LuckfoxTECH/Luckfox-Omni3576-docs/README.md

# Luckfox Omni3576 Documentation

This repository contains the documentation, hardware resources, tools, and example code for Luckfox Omni3576

## Directory Structure

```text
Luckfox-Omni3576-docs/
├── Code/
├── Docs/
│   ├── datasheets/
│   ├── en/
│   └── zh/
├── Hardware/
│   ├── 3D Models/
│   ├── CAD/
│   └── Schematic/
├── Tools/
├── README.md
└── .gitignore
```

## Directory Description

| Directory | Description |
| --- | --- |
| `Code/` | Example code, demo projects, scripts, and source files related to Luckfox Omni3576 development. |
| `Docs/datasheets/` | Chip datasheets, module specifications, interface documents, and other reference PDFs. |
| `Docs/en/` | English user manuals, tutorials, quick-start guides, and development notes. |
| `Docs/zh/` | Chinese user manuals, tutorials, quick-start guides, and development notes. |
| `Hardware/3D Models/` | 3D model files for mechanical design, enclosure design, and product preview. |
| `Hardware/CAD/` | CAD design files,and hardware design source files. |
| `Hardware/Schematic/` | Circuit schematic files and related hardware reference documents. |
| `Tools/` | Utility software, flashing tools, and auxiliary development tools. |

## Notes

- Keep file names clear and descriptive.
- Place documents in the matching language folder when possible.
- Put large binary files only in the appropriate resource directory.
