LuckfoxTECH/Luckfox-Omni3576-docs/Hardware/Core3576-Pinout.xlsx

Sheet: 40P
 | SAI | CAN | I2C | SPI | UART | PWM | 次要功能 | 主要功能 | GPIO |  |  | GPIO | 主要功能 | 次要功能 | I2C | SPI | UART | PWM | SAI | CAN
 | 3.3V |  |  |  |  |  |  |  |  | 3.3V | 5V
18 |  |  | I2C0_SDA_M1 | - | UART8_RX_M2 | - |  | I2C0_SDA_M1 | GPIO0_C2_d | SDA0_1 | 5V
17 |  |  | I2C0_SCL_M1 | - | UART8_TX_M2 | - |  | I2C0_SCL_M1 | GPIO0_C1_d | SCL0_1 | GND
70 |  |  |  |  |  | - | UART8_TX_M1 |  | GPIO2_A6_d | TXD8_1 | TXD2_1 | GPIO4_B5_d | UART2_TX_M1 |  | I2C3_SCL_M0 | - | UART2_TX_M1 | - |  |  | 141
 | GND |  |  |  |  |  |  |  |  | GND | RXD2_1 | GPIO4_B4_d | UART2_RX_M1 |  | I2C3_SDA_M0 | - | UART2_RX_M1 | - |  |  | 140
98 | SAI3_SDO_M2 | CAN1_TX_M3 | - | - | UART3_CTSN_M0 | - |  |  | GPIO3_A2_d | GPIO17 | PWM2_0 | GPIO0_D3_d | PWM2_CH0 |  |  | - |  | PWM2_CH0 |  |  | 27
99 | SAI3_SDI_M2 | CAN1_RX_M3 | - | - | UART3_RTSN_M0 | - |  |  | GPIO3_A3_d | GPIO27 | GND
13 |  |  | I2C1_SDA_M1 | - |  | PWM1_CH1 | I2C1_SDA_M1 |  | GPIO0_B5_d | GPIO22 | GPIO23 | GPIO0_B4_d |  | I2C1_SCL_M1 | I2C1_SCL_M1 | - |  | PWM1_CH0 |  |  | 12
 | 3.3V |  |  |  |  |  |  |  |  | 3.3V | GPIO24 | GPIO0_C5_d |  |  | - | - |  | - |  |  | 21
24 |  |  | - | SPI0_MOSI_M0 | - | - |  | SPI0_MOSI_M0 | GPIO0_D0_d | MOSI0_0 | GND
25 |  |  | - | SPI0_MISO_M0 | - | - |  | SPI0_MISO_M0 | GPIO0_D1_d | MISO0_0 | GPIO25 | GPIO2_B5_d |  |  | - |  |  | - |  |  | 77
23 |  |  | I2C3_SDA_M1 | SPI0_CLK_M0 | - | - |  | SPI0_CLK_M0 | GPIO0_C7_d | SCLK0_0 | CE0_0 | GPIO0_C6_d | SPI0_CSN0_M0 |  | I2C3_SCL_M1 | SPI0_CSN0_M0 | - | - |  |  | 22
 | GND |  |  |  |  |  |  |  |  | GND | CE1_0 | GPIO0_C3_d | SPI0_CSN1_M0 |  | - | SPI0_CSN1_M0 | - | PWM0_CH1 |  |  | 19
79 |  |  | I2C8_SDA_M2 | - | UART7_RX_M0 | - |  | I2C8_SDA_M2 | GPIO2_B7_d | SDA8_2 | SCL8_2 | GPIO2_B6_d | I2C8_SCL_M2 |  | I2C8_SCL_M2 | - | UART7_TX_M0 | - |  |  | 78
71 |  |  |  | - | UART8_RX_M1 | - | UART8_RX_M1 |  | GPIO2_A7_d | RXD8_1 | GND
151 |  |  |  |  |  |  |  |  | GPIO4_C7_d | GPIO6 | GPIO12 | GPIO3_A0_d | UART3_TX_M0 |  | I2C7_SCL_M1 |  | UART3_TX_M0 | - | SAI3_SCLK_M2 |  | 96
97 | SAI3_LRCK_M2 |  | I2C7_SDA_M1 |  | UART3_RX_M0 |  | UART3_RX_M0 |  | GPIO3_A1_d | GPIO13 | GND
138 |  |  | - | SPI4_MISO_M2 | - | - | SPI4_MISO_M2 |  | GPIO4_B2_d | MISO4_2 | GPIO16 | GPIO2_D7_d |  |  | - |  |  |  |  |  | 95
72 |  |  | - | - |  | - |  |  | GPIO2_B0_d | GPIO26 | MOSI4_2 | GPIO4_B1_d |  | SPI4_MOSI_M2 |  | SPI4_MOSI_M2 | UART5_RX_M1 |  |  |  | 137
 | GND |  |  |  |  |  |  |  |  | GND | SCLK4_2 | GPIO4_B0_d |  | SPI4_CLK_M2 |  | SPI4_CLK_M2 | UART5_TX_M1 |  |  |  | 136

Sheet: 260P
Pin Number | Pin Name | IO Power domain | Omni3576 Definition |  | Pin Number | Pin Name | IO Power domain | Omni3576 Definition | @onepiece(onepiece)
1 | GND |  | GND |  | 2 | GND |  | GND
3 | USB2_OTG0_DP | - | USB2_OTG0_DP |  | 4 | USB2_OTG0_ID | - | NC
5 | USB2_OTG0_DM | - | USB2_OTG0_DM |  | 6 | USB2_OTG0_VBUSDET | - | USB2_OTG0_VBUSDET
7 | USB3_OTG0_SSRX1P / DP_TX_D0P | - | USB3_OTG0_SSRX1P |  | 8 | USB2_OTG1_DP | - | USB2_HOST1_DP
9 | USB3_OTG0_SSRX1N / DP_TX_D0N | - | USB3_OTG0_SSRX1N |  | 10 | USB2_OTG1_DM | - | USB2_HOST1_DM
11 | USB3_OTG0_SSTX1P / DP_TX_D1P | - | USB3_OTG0_SSTX1P |  | 12 | GND |  | GND
13 | USB3_OTG0_SSTX1N / DP_TX_D1N | - | USB3_OTG0_SSTX1N |  | 14 | NPOR |  | RESET_L
15 | USB3_OTG0_SSRX2P / DP_TX_D2P | - | USB3_OTG0_SSRX2N |  | 16 | REF_CLK0_OUT / AUPLL_CLK_IN_M0 / GPIO0_A0_d | 1V8 | REF_CLK0_OUT
17 | USB3_OTG0_SSRX2N / DP_TX_D2N | - | USB3_OTG0_SSRX2P |  | 18 | SDMMC0_DETN / SPI2_CSN1_M0 / GPIO0_A7_u | 1V8 | SDMMC0_DET_L
19 | USB3_OTG0_SSTX2P / DP_TX_D3P | - | USB3_OTG0_SSTX2P |  | 20 | AUPLL_CLK_IN_M1 / SPI2_CSN0_M0 / I2C0_SCL_M0 / GPIO0_B0_z | 1V8 | WIFI_WAKE_HOST_H
21 | USB3_OTG0_SSTX2N / DP_TX_D3N | - | USB3_OTG0_SSTX2N |  | 22 | SPI2_MISO_M0 / I2C0_SDA_M0 / GPIO0_B1_z | 1V8 | BT_WAKE_HOST_H
23 | GND |  | GND |  | 24 | REF_CLK1_OUT / I2C1_SCL_M1 / UART4_TX_M2 / PWM1_CH0_M0 / GPIO0_B4_d | 3V3 | GPIO_16
25 | MIPI_DPHY_DSI_TX_D0N / MIPI_CPHY_DSI_TX_TRIO0_A | - | MIPI_DPHY_DSI_TX_D0N |  | 26 | REF_CLK2_OUT / I2C1_SDA_M1 / UART4_RX_M2 / PWM1_CH1_M0 / GPIO0_B5_d | 3V3 | GPIO_15
27 | MIPI_DPHY_DSI_TX_D0P / MIPI_CPHY_DSI_TX_TRIO0_B | - | MIPI_DPHY_DSI_TX_D0P |  | 28 | SDMMC0_PWREN / SDMMC1_DETN_M2 / HDMI_TX_HPDIN_M1 / EDP_TX_HPDIN_M1 / PWM1_CH2_M0 / GPIO0_B6_d | 3V3 | SDMMC0_PWREN_H
29 | MIPI_DPHY_DSI_TX_D1N / MIPI_CPHY_DSI_TX_TRIO0_C | - | MIPI_DPHY_DSI_TX_D1N |  | 30 | I2C2_SCL_M0 / UART1_TX_M0 / NPU_AVS / PWM1_CH4_M0 / GPIO0_B7_d | 3V3 | I2C2_SCL_M0_CC_RTC
31 | MIPI_DPHY_DSI_TX_D1P / MIPI_CPHY_DSI_TX_TRIO1_A | - | MIPI_DPHY_DSI_TX_D1P |  | 32 | I2C2_SDA_M0 / UART1_RX_M0 / CPULIT_AVS / PWM1_CH3_M0 / GPIO0_C0_d | 3V3 | I2C2_SDA_M0_CC_RTC
33 | MIPI_DPHY_DSI_TX_CLKN / MIPI_CPHY_DSI_TX_TRIO1_B | - | MIPI_DPHY_DSI_TX_CLKN |  | 34 | I2C0_SCL_M1 / UART8_TX_M2 / I3C0_SCL_M0 / GPIO0_C1_d | 3V3 | GPIO_5
35 | MIPI_DPHY_DSI_TX_CLKP / MIPI_CPHY_DSI_TX_TRIO1_C | - | MIPI_DPHY_DSI_TX_CLKP |  | 36 | I2C0_SDA_M1 / UART8_RX_M2 / I3C0_SDA_M0 / GPIO0_C2_d | 3V3 | GPIO_3
37 | MIPI_DPHY_DSI_TX_D2N / MIPI_CPHY_DSI_TX_TRIO2_A | - | MIPI_DPHY_DSI_TX_D2N |  | 38 | PDM0_CLK1_M0 / HDMI_TX_CEC_M1 / SPI0_CSN1_M0 / PWM0_CH1_M0 / GPIO0_C3_d | 3V3 | GPIO_26
39 | MIPI_DPHY_DSI_TX_D2P / MIPI_CPHY_DSI_TX_TRIO2_B | - | MIPI_DPHY_DSI_TX_D2P |  | 40 | SAI0_MCLK_M1 / PDM0_CLK0_M0 / UART10_TX_M2 / PWM0_CH0_M0 / GPIO0_C4_d | 3V3 | PWM0_CH0_M0_IR
41 | MIPI_DPHY_DSI_TX_D3N / MIPI_CPHY_DSI_TX_TRIO2_C | - | MIPI_DPHY_DSI_TX_D3N |  | 42 | SAI0_SDO0_M1 / DP_HPDIN_M1 / UART10_RX_M2 / I3C0_SDA_PU_M0 / GPIO0_C5_d | 3V3 | GPIO_18
43 | MIPI_DPHY_DSI_TX_D3P / NO_USE | - | MIPI_DPHY_DSI_TX_D3P |  | 44 | SAI0_SCLK_M1 / I2C3_SCL_M1 / SPI0_CSN0_M0 / GPIO0_C6_d | 3V3 | GPIO_24
45 | GND |  | GND |  | 46 | SAI0_LRCK_M1 / I2C3_SDA_M1 / SPI0_CLK_M0 / GPIO0_C7_d | 3V3 | GPIO_23
47 | MIPI_DPHY_CSI0_RX_D0N / MIPI_CPHY_CSI_RX_TRIO0_A | - | MIPI_DPHY_CSI0_RX_D0N |  | 48 | SAI0_SDI0_M1 / PDM0_SDI0_M0 / SPI0_MOSI_M0 / GPIO0_D0_d | 3V3 | GPIO_19
49 | MIPI_DPHY_CSI0_RX_D0P / MIPI_CPHY_CSI_RX_TRIO0_B | - | MIPI_DPHY_CSI0_RX_D0P |  | 50 | SAI0_SDI1_M1 / SAI0_SDO3_M1 / PDM0_SDI1_M0 / SPI0_MISO_M0 / GPIO0_D1_d | 3V3 | GPIO_21
51 | MIPI_DPHY_CSI0_RX_D1N / MIPI_CPHY_CSI_RX_TRIO0_C | - | MIPI_DPHY_CSI0_RX_D1N |  | 52 | SAI0_SDI2_M1 / SAI0_SDO2_M1 / PDM0_SDI2_M0 / I2C4_SCL_M0 / CPUBIG_AVS / PWM1_CH5_M0 / UART1_CTSN_M0 / GPIO0_D2_d | 3V3 | PCIE0_WAKEn_M0
53 | MIPI_DPHY_CSI0_RX_D1P / MIPI_CPHY_CSI_RX_TRIO1_A | - | MIPI_DPHY_CSI0_RX_D1P |  | 54 | SAI0_SDI3_M1 / SAI0_SDO1_M1 / PDM0_SDI3_M0 / I2C4_SDA_M0 / GPU_AVS / PWM2_CH0_M0 / UART1_RTSN_M0 / GPIO0_D3_d | 3V3 | GPIO_12
55 | MIPI_DPHY_CSI0_RX_CLKN / MIPI_CPHY_CSI_RX_TRIO1_B | - | MIPI_DPHY_CSI0_RX_CLKN |  | 56 | UART0_TX_M0 / JTAG_TCK_M1 / GPIO0_D4_u | 3V3 | UART0_TX_M0_DEBUG
57 | MIPI_DPHY_CSI0_RX_CLKP / MIPI_CPHY_CSI_RX_TRIO1_C | - | MIPI_DPHY_CSI0_RX_CLKP |  | 58 | UART0_RX_M0 / JTAG_TMS_M1 / GPIO0_D5_u | 3V3 | UART0_RX_M0_DEBUG
59 | MIPI_DPHY_CSI0_RX_D2N / MIPI_CPHY_CSI_RX_TRIO2_A | - | MIPI_DPHY_CSI0_RX_D2N |  | 60 | GND |  | GND
61 | MIPI_DPHY_CSI0_RX_D2P / MIPI_CPHY_CSI_RX_TRIO2_B | - | MIPI_DPHY_CSI0_RX_D2P |  | 62 | HDMI_TX_SBDN / EDP_TX_AUXN | - | HDMI_TX_SBDN
63 | MIPI_DPHY_CSI0_RX_D3N / MIPI_CPHY_CSI_RX_TRIO2_C | - | MIPI_DPHY_CSI0_RX_D3N |  | 64 | HDMI_TX_SBDP / EDP_TX_AUXP | - | HDMI_TX_SBDP
65 | MIPI_DPHY_CSI0_RX_D3P / NO_USE | - | MIPI_DPHY_CSI0_RX_D3P |  | 66 | DSM_AUD_LP_M1 / SAI4_MCLK_M2 / HDMI_TX_CEC_M0 / I2C7_SCL_M3 / SPI4_CSN1_M0 / UART11_TX_M2 / PWM1_CH5_M1 / GPIO4_C0_d | 3V3 | HDMI_TX_CEC_PORT
67 | GND |  | GND |  | 68 | DSM_AUD_LN_M1 / HDMI_TX_HPDIN_M0 / PCIE1_CLKREQN_M3 / I2C7_SDA_M3 / EDP_TX_HPDIN_M0 / UART11_RX_M2 / PWM0_CH1_M1 / GPIO4_C1_d | 3V3 | HDMITX_HPDIN / HDMITX_SBDN
69 | HDMI_TX_D3N / EDP_TX_D3N | - | HDMI_TX_D3N |  | 70 | DSM_AUD_RP_M1 / HDMI_TX_SCL / I2C2_SCL_M3 / CAN0_TX_M1 / UART9_TX_M2 / PWM2_CH0_M1 / GPIO4_C2_d | 3V3 | HDMI_TX_SCL_PORT
71 | HDMI_TX_D3P / EDP_TX_D3P | - | HDMI_TX_D3P |  | 72 | DSM_AUD_RN_M1 / HDMI_TX_SDA / I2C2_SDA_M3 / CAN0_RX_M1 / UART9_RX_M2 / PWM2_CH1_M1 / GPIO4_C3_d | 3V3 | HDMI_TX_SDA_PORT
73 | HDMI_TX_D0N / EDP_TX_D0N | - | HDMI_TX_D0N |  | 74 | ISP_PRELIGHT_TRIG_M1 / SAI4_LRCK_M2 / DP_HPDIN_M0 / I2C3_SCL_M3 / SPI4_CSN0_M0 / UART6_TX_M3 / PWM2_CH6_M1 / GPIO4_C4_d | 3V3 | TYPEC_DPTX_AUX_PUPDCTL1
75 | HDMI_TX_D0P / EDP_TX_D0P | - | HDMI_TX_D0P |  | 76 | ISP_FLASH_TRIGOUT_M1 / SAI4_SDO_M2 / VP0_SYNC_OUT / SATA1_ACTLED_M1 / I2C3_SDA_M3 / SPI4_MOSI_M0 / UART6_RX_M3 / PWM2_CH5_M1 / GPIO4_C5_d | 3V3 | TYPEC_DPTX_AUX_PUPDCTL2
77 | HDMI_TX_D1N / EDP_TX_D1N | - | HDMI_TX_D1N |  | 78 | SAI4_SDI_M2 / VP1_SYNC_OUT / PCIE0_CLKREQN_M3 / SATA0_ACTLED_M1 / I2C6_SCL_M3 / SPI4_MISO_M0 / CAN1_TX_M1 / PWM2_CH2_M1 / GPIO4_C6_d | 3V3 | HDMI_TX_ON_H
79 | HDMI_TX_D1P / EDP_TX_D1P | - | HDMI_TX_D1P |  | 80 | SAI4_SCLK_M2 / VP2_SYNC_OUT / I2C6_SDA_M3 / SPI4_CLK_M0 / CAN1_RX_M1 / PWM2_CH3_M1 / GPIO4_C7_d | 3V3 | GPIO_31
81 | HDMI_TX_D2N / EDP_TX_D2N | - | HDMI_TX_D2N |  | 82 | DP_TX_AUXP | - | DP_TX_AUXP
83 | HDMI_TX_D2P / EDP_TX_D2P | - | HDMI_TX_D2P |  | 84 | DP_TX_AUXN | - | DP_TX_AUXN
85 | GND |  | GND |  | 86 | MIPI_DPHY_CSI1_RX_CLKN | - | MIPI_DPHY_CSI1_RX_CLKN
87 | MIPI_DPHY_CSI1_RX_D3N / MIPI_DPHY_CSI2_RX_D1N | - | MIPI_DPHY_CSI1_RX_D3N |  | 88 | MIPI_DPHY_CSI1_RX_CLKP | - | MIPI_DPHY_CSI1_RX_CLKP
89 | MIPI_DPHY_CSI1_RX_D3P / MIPI_DPHY_CSI2_RX_D1P | - | MIPI_DPHY_CSI1_RX_D3P |  | 90 | MIPI_DPHY_CSI2_RX_CLKN | - | NC
91 | MIPI_DPHY_CSI1_RX_D2N / MIPI_DPHY_CSI2_RX_D0N | - | MIPI_DPHY_CSI1_RX_D2N |  | 92 | MIPI_DPHY_CSI2_RX_CLKP | - | NC
93 | MIPI_DPHY_CSI1_RX_D2P / MIPI_DPHY_CSI2_RX_D0P | - | MIPI_DPHY_CSI1_RX_D2P |  | 94 | MIPI_DPHY_CSI4_RX_CLKN | - | NC
95 | MIPI_DPHY_CSI1_RX_D1N | - | MIPI_DPHY_CSI1_RX_D1N |  | 96 | MIPI_DPHY_CSI4_RX_CLKP | - | NC
97 | MIPI_DPHY_CSI1_RX_D1P | - | MIPI_DPHY_CSI1_RX_D1P |  | 98 | GND |  | GND
99 | MIPI_DPHY_CSI1_RX_D0N | - | MIPI_DPHY_CSI1_RX_D0N |  | 100 | PCIE0_REFCLKP | - | PCIE0_REFCLKP
101 | MIPI_DPHY_CSI1_RX_D0P | - | MIPI_DPHY_CSI1_RX_D0P |  | 102 | PCIE0_REFCLKN | - | PCIE0_REFCLKN
103 | GND |  | GND |  | 104 | PCIE1_REFCLKP | - | NC
105 | PCIE0_RXP / SATA0_RXP | - | PCIE0_RXP |  | 106 | PCIE1_REFCLKN | - | NC
107 | PCIE0_RXN / SATA0_RXN | - | PCIE0_RXN |  | 108 | MIPI_DPHY_CSI3_RX_CLKN | - | NC
109 | PCIE0_TXP / SATA0_TXP | - | PCIE0_TXN |  | 110 | MIPI_DPHY_CSI3_RX_CLKP | - | NC
111 | PCIE0_TXN / SATA0_TXN | - | PCIE0_TXP |  | 112 | GND |  | GND
113 | GND |  | GND |  | 114 | ETH1_RXD2_M1 / SDMMC1_D0_M0 / SAI3_SCLK_M1 / I2C9_SDA_M1 / SPI1_CLK_M0 / PCIE1_CLKREQN_M1 / PWM1_CH0_M1 / GPIO1_B4_d | 1V8 | SDMMC1_D0_M0
115 | PCIE1_TXP / SATA1_TXP / USB3_OTG1_SSTXP | - | USB3_HOST1_SSTXP |  | 116 | ETH1_RXD3_M1 / SDMMC1_D1_M0 / SAI3_LRCK_M1 / I2C9_SCL_M1 / SPI1_MOSI_M0 / PWM1_CH1_M1 / GPIO1_B5_d | 1V8 | SDMMC1_D1_M0
117 | PCIE1_TXN / SATA1_TXN / USB3_OTG1_SSTXN | - | USB3_HOST1_SSTXN |  | 118 | ETH1_RXCLK_M1 / SDMMC1_D2_M0 / SAI3_SDO_M1 / UART3_CTSN_M2 / SPI1_MISO_M0 / PCIE0_CLKREQN_M1 / GPIO1_B6_d | 1V8 | SDMMC1_D2_M0
119 | PCIE1_RXP / SATA1_RXP / USB3_OTG1_SSRXP | - | USB3_HOST1_SSRXP |  | 120 | ETH1_TXD2_M1 / SDMMC1_D3_M0 / SAI3_SDI_M1 / UART3_RTSN_M2 / SPI1_CSN0_M0 / GPIO1_B7_d | 1V8 | SDMMC1_D3_M0
121 | PCIE1_RXN / SATA1_RXN / USB3_OTG1_SSRXN | - | USB3_HOST1_SSRXN |  | 122 | ETH1_TXD3_M1 / SDMMC1_CMD_M0 / PDM0_SDI2_M2 / UART3_TX_M2 / SPI1_CSN1_M0 / PWM0_CH0_M1 / GPIO1_C0_d | 1V8 | SDMMC1_CMD_M0
123 | GND |  | GND |  | 124 | ETH1_TXCLK_M1 / SDMMC1_CLK_M0 / SAI3_MCLK_M1 / PDM0_CLK0_M2 / UART3_RX_M2 / GPIO1_C1_d | 1V8 | SDMMC1_CLK_M0
125 | MIPI_DPHY_CSI3_RX_D3N / MIPI_DPHY_CSI4_RX_D1N | - | NC |  | 126 | ETH1_PPSCLK_M1 / SDMMC1_PWREN_M0 / FSPI1_RSTN_M1 / FSPI1_CSN1_M1 / UART4_RTSN_M1 / I2C6_SCL_M1 / SPI2_CSN1_M1 / PWM1_CH2_M1 / GPIO1_C2_u | 1V8 | UART4_RTSN_M1
127 | MIPI_DPHY_CSI3_RX_D3P / MIPI_DPHY_CSI4_RX_D1P | - | NC |  | 128 | ETH1_PPSTRIG_M1 / SDMMC1_DETN_M0 / FSPI1_CSN0_M1 / UART4_CTSN_M1 / I2C6_SDA_M1 / SPI2_CSN0_M1 / GPIO1_C3_u | 1V8 | UART4_CTSN_M1
129 | MIPI_DPHY_CSI3_RX_D2N / MIPI_DPHY_CSI4_RX_D0N | - | NC |  | 130 | ETH1_TXD0_M1 / FSPI1_D0_M1 / UART4_TX_M1 / UART2_RTSN_M0 / SPI2_MOSI_M1 / PCIE0_BUTTONRSTN / GPIO1_C4_d | 1V8 | UART4_TX_M1
131 | MIPI_DPHY_CSI3_RX_D2P / MIPI_DPHY_CSI4_RX_D0P | - | NC |  | 132 | ETH1_TXD1_M1 / FSPI1_D1_M1 / UART4_RX_M1 / UART2_CTSN_M0 / SPI2_MISO_M1 / PCIE1_BUTTONRSTN / GPIO1_C5_d | 1V8 | UART4_RX_M1
133 | MIPI_DPHY_CSI3_RX_D1N | - | NC |  | 134 | ETH1_RXD0_M1 / FSPI1_D3_M1 / PDM0_SDI1_M2 / UART2_RX_M0 / I2C8_SDA_M1 / SATA_CPDET / GPIO1_C7_d | 1V8 | BT_REG_ON_H
135 | MIPI_DPHY_CSI3_RX_D1P | - | NC |  | 136 | ETH_CLK1_25M_OUT_M1 / FSPI1_CLK_M1 / PDM0_CLK1_M2 / SPDIF_TX1_M2 / UART10_CTSN_M1 / I2C5_SDA_M1 / SPI2_CLK_M1 / SATA_MPSWIT / CLK1_32K_OUT / GPIO1_D5_d | 1V8 | CLK1_32K_OUT_WIFI
137 | MIPI_DPHY_CSI3_RX_D0N | - | NC |  | 138 | ETH1_MCLK_M1 / SAI2_MCLK_M0 / PDM0_SDI3_M2 / SPDIF_RX1_M2 / UART10_RTSN_M1 / I2C5_SCL_M1 / GPIO1_D4_d | 1V8 | HOST_WAKE_BT_H
139 | MIPI_DPHY_CSI3_RX_D0P | - | NC |  | 140 | RTC_BAT | - | RTC_BAT
141 | GND |  | GND |  | 142 | CAM_CLK2_OUT_M1 / ETH1_MCLK_M0 / ETH_CLK0_25M_OUT_M1 / SAI0_SDO3_M0 / SPDIF_TX0_M2 / UART9_CTSN_M0 / SPI3_CSN1_M0 / PWM2_CH7_M2 / GPIO2_D7_d | 3V3 | GPIO_36
143 | ETH1_TXCTL_M1 / FSPI1_D2_M1 / PDM0_SDI0_M2 / UART2_TX_M0 / I2C8_SCL_M1 / SATA_CPPOD / GPIO1_C6_d | 1V8 | WIFI_REG_ON_H |  | 144 | VI_CIF_CLKO / ETH1_PPSCLK_M0 / ETH0_RXCTL_M1 / SAI3_SDO_M2 / SPDIF_RX1_M1 / UART3_CTSN_M0 / SPI3_MISO_M0 / CAN1_TX_M3 / MIPI_TE_M1 / GPIO3_A2_d | 3V3 | GPIO_11
- | - | - | -
145 | ETH1_RXCTL_M1 / SAI2_SCLK_M0 / UART10_RX_M1 / I3C0_SDA_PU_M1 / GPIO1_D1_d | 1V8 | SAI2_SCLK_M0 |  | 146 | SDMMC0_D0 / FSPI1_D0_M0 / DSM_AUD_LP_M0 / UART0_RX_M1 / UART7_RX_M2 / I2C8_SCL_M0 / SPI0_MOSI_M1 / CAN0_RX_M0 / PWM2_CH2_M0 / GPIO2_A0_d | 3V3 | SDMMC0_D0
147 | ETH1_MDIO_M1 / SAI2_SDI_M0 / I3C0_SDA_M1 / PWM1_CH4_M1 / GPIO1_D3_d | 1V8 | SAI2_SDI_M0 |  | 148 | SDMMC0_D1 / FSPI1_D1_M0 / DSM_AUD_LN_M0 / SAI3_MCLK_M3 / UART0_TX_M1 / UART7_TX_M2 / I2C8_SDA_M0 / SPI0_MISO_M1 / CAN0_TX_M0 / PWM2_CH3_M0 / GPIO2_A1_d | 3V3 | SDMMC0_D1
149 | ETH1_RXD1_M1 / SAI2_SDO_M0 / UART10_TX_M1 / GPIO1_D0_d | 1V8 | SAI2_SDO_M0 |  | 150 | SDMMC0_D2 / FSPI1_D2_M0 / DSM_AUD_RP_M0 / SAI3_LRCK_M3 / JTAG_TCK_M0 / UART5_RTSN_M2 / SPI0_CSN1_M1 / CAN1_RX_M0 / I3C1_SCL_M1 / GPIO2_A2_d | 3V3 | SDMMC0_D2
151 | ETH1_MDC_M1 / SAI2_LRCK_M0 / I3C0_SCL_M1 / PWM1_CH3_M1 / GPIO1_D2_d | 1V8 | SAI2_LRCK_M0 |  | 152 | SDMMC0_D3 / FSPI1_D3_M0 / DSM_AUD_RN_M0 / SAI3_SDI_M3 / JTAG_TMS_M0 / UART5_CTSN_M2 / CAN1_TX_M0 / I3C1_SDA_M1 / GPIO2_A3_d | 3V3 | SDMMC0_D3
153 | VI_CIF_D15 / SDMMC1_D0_M1 / ETH0_RXD0_M1 / SAI0_SDO0_M0 / UART8_TX_M1 / SPI4_CSN1_M3 / I2C4_SCL_M2 / GPIO2_A6_d | 3V3 | GPIO_7 |  | 154 | SDMMC0_CMD / FSPI1_CSN0_M0 / SAI3_SDO_M3 / UART5_RX_M2 / I2C5_SDA_M0 / SPI0_CSN0_M1 / PWM2_CH4_M0 / GPIO2_A4_d | 3V3 | SDMMC0_CMD
155 | VI_CIF_CLKI / ETH1_PTP_REFCLK_M0 / ETH0_RXD1_M1 / SAI3_SDI_M2 / SPDIF_TX1_M1 / UART3_RTSN_M0 / SPI3_CSN0_M0 / CAN1_RX_M3 / GPIO3_A3_d | 3V3 | GPIO_13 |  | 156 | SDMMC0_CLK / FSPI1_CLK_M0 / SAI3_SCLK_M3 / TEST_CLK_OUT / UART5_TX_M2 / I2C5_SCL_M0 / SPI0_CLK_M1 / I3C1_SDA_PU_M1 / GPIO2_A5_d | 3V3 | SDMMC0_CLK
157 | VI_CIF_D6 / ETH0_RXD2_M1 / SAI0_LRCK_M0 / UART7_RX_M0 / UART8_CTSN_M1 / I2C8_SDA_M2 / GPIO2_B7_d | 3V3 | GPIO_27 |  | 158 | VO_LCDC_D12 / VO_EBC_SDDO12 / ETH0_PPSTRIG_M0 / SAI1_SDI0_M1 / DSMC_DQS0 / FLEXBUS1_D10 / FLEXBUS1_CSN_M0 / UART2_RX_M2 / UART3_CTSN_M1 / I2C4_SDA_M3 / GPIO3_B7_d | 1V8 | I2C4_SDA_M3_MIPI_CAM0 / 2
159 | VI_CIF_D7 / ETH1_PTP_REFCLK_M1 / ETH0_RXD3_M1 / SAI0_SCLK_M0 / UART7_TX_M0 / UART8_RTSN_M1 / I2C8_SCL_M2 / GPIO2_B6_d | 3V3 | GPIO_28 | 3 | 160 | VO_LCDC_D11 / VO_EBC_SDDO11 / ETH0_PPSCLK_M0 / SAI1_SDO3_M1 / DSMC_DATA7 / FLEXBUS1_D9 / UART2_TX_M2 / UART3_RTSN_M1 / I2C4_SCL_M3 / GPIO3_C0_d | 1V8 | I2C4_SCL_M3_MIPI_CAM0 / 2
161 | VI_CIF_D8 / SDMMC1_DETN_M1 / ETH0_RXCLK_M1 / SAI0_MCLK_M0 / PDM0_CLK0_M3 / UART7_RTSN_M0 / SPI4_MISO_M3 / SATA1_ACTLED_M0 / GPIO2_B5_d | 3V3 | GPIO_22 |  | 162 | VO_LCDC_D10 / VO_EBC_SDDO10 / ETH0_PTP_REFCLK_M0 / SAI1_SDO2_M1 / DSMC_DATA6 / FLEXBUS1_D8 / UART11_RX_M0 / SPI2_MISO_M2 / I2C5_SDA_M3 / CAN0_RX_M3 / GPIO3_C1_d | 1V8 | I2C5_SDA_M3_MIPI_CAM1 / HDMI_RX
163 | VI_CIF_D14 / SDMMC1_D1_M1 / ETH0_TXCTL_M1 / SAI0_SDO1_M0 / UART8_RX_M1 / I2C4_SDA_M2 / GPIO2_A7_d | 3V3 | GPIO_29 |  | 164 | VO_LCDC_D7 / VO_EBC_SDDO7 / SAI1_SDO1_M1 / DSMC_DATA5 / FLEXBUS1_D7 / UART11_TX_M0 / SPI2_CSN0_M2 / I2C5_SCL_M3 / CAN0_TX_M3 / GPIO3_C4_d | 1V8 | I2C5_SCL_M3_MIPI_CAM1 / HDMI_RX
165 | VI_CIF_D12 / SDMMC1_D3_M1 / ETH0_TXD0_M1 / SAI0_SDI1_M0 / PDM0_SDI2_M3 / UART1_RX_M1 / GPIO2_B1_d | 3V3 | PCIE0_PERSTn |  | 166 | VO_LCDC_D6 / VO_EBC_SDDO6 / SAI1_SDO0_M1 / DSMC_DATA4 / FLEXBUS1_D6 / UART8_RX_M0 / SPI1_MISO_M2 / PWM2_CH2_M3 / GPIO3_C5_d | 1V8 | DSI_IO1
167 | VI_CIF_D13 / SDMMC1_D2_M1 / ETH0_TXD1_M1 / SAI0_SDI0_M0 / PDM0_SDI3_M3 / UART1_TX_M1 / GPIO2_B0_d | 3V3 | GPIO_37 |  | 168 | VO_LCDC_D5 / VO_EBC_SDDO5 / SAI1_LRCK_M1 / DSMC_DATA3 / FLEXBUS1_D5 / UART8_TX_M0 / SPI1_MOSI_M2 / GPIO3_C6_d | 1V8 | CSI0_IO0
169 | GND |  | GND |  | 170 | VO_LCDC_D4 / VO_EBC_SDDO4 / SAI1_SCLK_M1 / DSMC_DATA2 / FLEXBUS1_D4 / UART8_RTSN_M0 / SPI1_CLK_M2 / GPIO3_C7_d | 1V8 | CSI1_IO1
171 | VI_CIF_D3 / ETH1_RXCLK_M0 / ETH0_PPSTRIG_M1 / SAI2_SCLK_M1 / PDM1_SDI2_M0 / UART11_CTSN_M1 / SPI1_MOSI_M1 / PWM1_CH2_M2 / GPIO2_C2_d | 3V3 | GMAC1_RXCLK_M0 |  | 172 | VO_LCDC_D3 / VO_EBC_SDDO3 / SAI1_MCLK_M1 / DSMC_DATA1 / FLEXBUS1_D3 / UART8_CTSN_M0 / SPI1_CSN0_M2 / PWM2_CH3_M3 / GPIO3_D0_d | 1V8 | CSI1_IO0
173 | VI_CIF_D0 / ETH1_TXCLK_M0 / SAI2_SDI_M1 / PDM1_CLK0_M0 / UART11_RX_M1 / SPI1_CLK_M1 / PWM1_CH4_M2 / GPIO2_C5_d | 3V3 | GMAC1_TXCLK_M0 |  | 174 | VO_LCDC_DEN / VO_EBC_SDLE / SAI1_SDI1_M1 / DSMC_DATA0 / FLEXBUS1_D1 / UART5_RX_M0 / SPI3_CLK_M1 / I2C3_SCL_M2 / GPIO3_D4_d | 1V8 | USBC_INT
175 | VI_CIF_HREF / ETH0_MDIO_M1 / SAI3_SCLK_M2 / UART3_TX_M0 / SPI3_CLK_M0 / I2C7_SCL_M1 / GPIO3_A0_d | 3V3 | GPIO_32 |  | 176 | VO_LCDC_HSYNC / VO_EBC_GDCLK / SAI1_SDI2_M1 / DSMC_CLKP / FLEXBUS1_D0 / UART5_TX_M0 / SPI3_MISO_M1 / I2C3_SDA_M2 / GPIO3_D5_d | 1V8 | USBC_PWR
177 | VI_CIF_VSYNC / ETH1_PPSTRIG_M0 / ETH0_MDC_M1 / SAI3_LRCK_M2 / UART3_RX_M0 / SPI3_MOSI_M0 / I2C7_SDA_M1 / GPIO3_A1_d | 3V3 | GPIO_33 |  | 178 | VO_LCDC_VSYNC / VO_EBC_SDCLK / SAI1_SDI3_M1 / DSMC_CLKN / FLEXBUS1_CLK / UART5_CTSN_M0 / SPI3_MOSI_M1 / PWM2_CH6_M3 / GPIO3_D6_d | 1V8 | FAN_PWM
179 | CAM_CLK1_OUT_M1 / ETH_CLK1_25M_OUT_M0 / ETH0_MCLK_M1 / SAI3_MCLK_M2 / SPDIF_RX0_M2 / UART9_RTSN_M0 / I3C1_SDA_PU_M0 / PWM2_CH6_M2 / GPIO2_D6_d | 3V3 | ETH_CLK1_25M_OUT_M0 |  | 180 | SPDIF_RX0_M1 / CAM_CLK1_OUT_M0 / SAI4_LRCK_M1 / DSMC_INT0 / FLEXBUS0_D13_M0 / FLEXBUS1_D14_M0 / FLEXBUS1_CSN_M3 / UART3_TX_M1 / SPI1_CSN1_M2 / I2C7_SCL_M2 / MIPI_TE_M2 / GPIO4_A0_d | 1V8 | PCIE_PWR
181 | ISP_PRELIGHT_TRIG_M0 / ETH1_MDC_M0 / UART6_RTSN_M1 / I2C9_SDA_M2 / PWM2_CH4_M2 / GPIO2_D4_d | 3V3 | GMAC1_MDC_M0 |  | 182 | VO_POST_EMPTY / SPDIF_TX0_M1 / CAM_CLK2_OUT_M0 / SAI4_SDO_M1 / DSMC_INT2 / FLEXBUS0_D14_M0 / FLEXBUS1_D13_M0 / FLEXBUS0_CSN_M1 / UART3_RX_M1 / I2C7_SDA_M2 / GPIO4_A1_d | 1V8 | M.2M_ALERT
183 | ISP_FLASH_TRIGOUT_M0 / ETH1_MDIO_M0 / UART6_CTSN_M1 / I2C9_SCL_M2 / PWM2_CH5_M2 / GPIO2_D5_d | 3V3 | GMAC1_MDIO_M0 |  | 184 | VO_LCDC_CLK / VO_EBC_SDOE / CAM_CLK0_OUT_M0 / SAI4_SCLK_M1 / DSMC_RESETN / FLEXBUS0_D15_M0 / FLEXBUS1_D12_M0 / FLEXBUS1_CSN_M1 / UART5_RTSN_M0 / SPI3_CSN1_M1 / PWM2_CH7_M3 / GPIO3_D7_d | 1V8 | CSI0_IO1
185 | VI_CIF_D9 / SDMMC1_PWREN_M1 / ETH0_TXD2_M1 / SAI0_SDI3_M0 / PDM0_SDI0_M3 / UART7_CTSN_M0 / SPI4_MOSI_M3 / SATA0_ACTLED_M0 / GPIO2_B4_d | 3V3 | GMAC1_RSTn |  | 186 | GND |  | GND
187 | VI_CIF_D11 / SDMMC1_CMD_M1 / ETH0_TXD3_M1 / SAI0_SDI2_M0 / PDM0_SDI1_M3 / UART1_CTSN_M1 / SPI4_CSN0_M3 / PCIE0_CLKREQN_M0 / GPIO2_B2_d | 3V3 | PCIE0_CLKREQn_M0 |  | 188 | SAI1_MCLK_M0 / SAI4_MCLK_M0 / AUPLL_CLK_IN_M2 / PWM2_CH5_M0 / GPIO4_A2_d | 3V3 | SAI1_MCLK_M0
189 | ETH1_RXCTL_M0 / UART6_RX_M1 / I3C1_SDA_M0 / PWM2_CH3_M2 / GPIO2_D3_d | 3V3 | GMAC1_RXCTL_M0 |  | 190 | SAI1_LRCK_M0 / FLEXBUS1_D12_M1 / SPI4_CSN1_M2 / UART5_CTSN_M1 / I2C2_SDA_M2 / PCIE1_CLKREQN_M2 / GPIO4_A5_d | 3V3 | SAI1_LRCK_M0
191 | ETH1_RXD0_M0 / SAI4_SDO_M3 / UART4_RX_M0 / I2C6_SDA_M2 / PWM2_CH1_M2 / GPIO2_D1_d | 3V3 | GMAC1_RXD0_M0 |  | 192 | SAI1_SCLK_M0 / FLEXBUS1_CSN_M4 / SPI3_CSN0_M2 / UART5_RTSN_M1 / I2C2_SCL_M2 / PWM2_CH4_M1 / GPIO4_A3_d | 3V3 | SAI1_SCLK_M0
193 | CAM_CLK0_OUT_M1 / ETH1_RXD1_M0 / SAI4_MCLK_M3 / UART6_TX_M1 / I3C1_SCL_M0 / PWM2_CH2_M2 / GPIO2_D2_d | 3V3 | GMAC1_RXD1_M0 |  | 194 | SAI4_LRCK_M0 / PDM1_CLK0_M1 / FLEXBUS0_D14_M1 / SPI3_MISO_M2 / UART6_RX_M0 / I2C4_SDA_M1 / CAN0_RX_M2 / GPIO4_A6_d | 3V3 | CAN0_RX_M2
195 | VI_CIF_D5 / ETH1_RXD2_M0 / ETH0_PTP_REFCLK_M1 / PDM1_SDI1_M0 / UART9_RX_M0 / PWM1_CH0_M2 / GPIO2_C0_d | 3V3 | GMAC1_RXD2_M0 |  | 196 | SAI4_SCLK_M0 / PDM1_SDI3_M1 / FLEXBUS0_D13_M1 / SPI3_MOSI_M2 / UART6_TX_M0 / I2C4_SCL_M1 / CAN0_TX_M2 / GPIO4_A4_d | 3V3 | CAN0_TX_M2
197 | VI_CIF_D4 / ETH1_RXD3_M0 / ETH0_PPSCLK_M1 / SAI2_MCLK_M1 / PDM1_CLK1_M0 / UART9_TX_M0 / SPI1_CSN1_M1 / PWM1_CH1_M2 / GPIO2_C1_d | 3V3 | GMAC1_RXD3_M0 |  | 198 | SAI1_SDO0_M0 / SAI4_SDI_M0 / SPI3_CLK_M2 / PWM2_CH6_M0 / GPIO4_A7_d | 3V3 | PWM2_CH6_M0_CAM SAI1_SDO0_M0
199 | ETH1_TXCTL_M0 / SAI4_SDI_M3 / UART4_TX_M0 / I2C6_SCL_M2 / PWM2_CH0_M2 / GPIO2_D0_d | 3V3 | GMAC1_TXCTL_M0 |  | 200 | SAI1_SDO1_M0 / SAI1_SDI3_M0 / PDM1_CLK1_M1 / FLEXBUS1_D13_M1 / SPI4_CLK_M2 / UART5_TX_M1 / UART6_RTSN_M0 / UART2_RTSN_M1 / GPIO4_B0_d | 3V3 | GPIO_40
201 | ETH1_TXD0_M0 / SAI4_SCLK_M3 / UART4_CTSN_M0 / I2C5_SCL_M2 / PWM1_CH5_M2 / GPIO2_C6_d | 3V3 | GMAC1_TXD0_M0 |  | 202 | SAI1_SDO2_M0 / SAI1_SDI2_M0 / PDM1_SDI2_M1 / FLEXBUS1_D14_M1 / SPI4_MOSI_M2 / UART5_RX_M1 / UART6_CTSN_M0 / UART2_CTSN_M1 / GPIO4_B1_d | 3V3 | GPIO_38
203 | ETH1_TXD1_M0 / SAI4_LRCK_M3 / UART4_RTSN_M0 / I2C5_SDA_M2 / PWM0_CH1_M2 / GPIO2_C7_d | 3V3 | GMAC1_TXD1_M0 |  | 204 | SAI1_SDO3_M0 / SAI1_SDI1_M0 / PDM1_SDI1_M1 / FLEXBUS1_D15_M1 / SPI4_MISO_M2 / MIPI_TE_M0 / GPIO4_B2_d | 3V3 | GPIO_35
205 | VI_CIF_D2 / ETH1_TXD2_M0 / SAI2_LRCK_M1 / PDM1_SDI3_M0 / UART11_RTSN_M1 / SPI1_MISO_M1 / PWM0_CH0_M2 / GPIO2_C3_d | 3V3 | GMAC1_TXD2_M0 |  | 206 | SAI1_SDI0_M0 / SAI4_SDO_M0 / PDM1_SDI0_M1 / SPI4_CSN0_M2 / SPI3_CSN1_M2 / PWM2_CH7_M0 / GPIO4_B3_d | 3V3 | SAI1_SDI0_M0
207 | VI_CIF_D1 / ETH1_TXD3_M0 / SAI2_SDO_M1 / PDM1_SDI0_M0 / UART11_TX_M1 / SPI1_CSN0_M1 / PWM1_CH3_M2 / GPIO2_C4_d | 3V3 | GMAC1_TXD3_M0 |  | 208 | SPDIF_RX0_M0 / FLEXBUS0_CSN_M4 / UART2_RX_M1 / I2C3_SDA_M0 / CAN1_RX_M2 / GPIO4_B4_d | 3V3 | GPIO_10
209 | VO_LCDC_D19 / VO_EBC_SDCE3 / ETH0_MCLK_M0 / SAI4_MCLK_M1 / DSMC_CSN1 / FLEXBUS0_D8 / UART10_RX_M0 / SPI2_MOSI_M2 / PWM0_CH0_M3 / GPIO3_B0_d | 1V8 | DSI_IO0 |  | 210 | SPDIF_TX0_M0 / FLEXBUS0_D15_M1 / UART2_TX_M1 / I2C3_SCL_M0 / PCIE0_CLKREQN_M2 / CAN1_TX_M2 / GPIO4_B5_d | 3V3 | GPIO_8
211 | GND |  | GND |  | 212 | GND |  | GND
213 | PHY0_LED1 / CFG_LDO0 | - | PHY0_LED1 / CFG_LDO0 |  | 214 | SARADC_IN0_BOOT | 1V8 | SARADC_VIN0_BOOT
215 | PHY0_LED2 / CFG_LDO1 | - | PHY0_LED2 / CFG_LDO1 |  | 216 | SARADC_IN1 | 1V8 | SARADC_VIN1_KEY / RECOVERY
217 | PHY0_MDI0+ | - | PHY0_MDI0+ |  | 218 | SARADC_IN3 | 1V8 | SARADC_VIN3_HP_HOOK
219 | PHY0_MDI0- | - | PHY0_MDI0- |  | 220 | SARADC_IN4 | 1V8 | SARADC_VIN4
221 | PHY0_MDI1+ | - | PHY0_MDI1+ |  | 222 | SARADC_IN5 | 1V8 | SARADC_VIN5
223 | PHY0_MDI1- | - | PHY0_MDI1- |  | 224 | SARADC_IN6 | 1V8 | SARADC_VIN6
225 | PHY0_MDI2+ | - | PHY0_MDI2+ |  | 226 | SARADC_IN7 | 1V8 | SARADC_VIN7
227 | PHY0_MDI2- | - | PHY0_MDI2- |  | 228 | GND |  | GND
229 | PHY0_MDI3+ | - | PHY0_MDI3+ |  | 230 | PMIC_EXT_EN_OUT |  | NC
231 | PHY0_MDI3- | - | PHY0_MDI3- |  | 232 | PWRON_L |  | PWRON_L
233 | GND |  | GND |  | 234 | 32KOUT_RTC2WIFI | 3V3 | 32KOUT_RTC2WIFI
235 | VCC_3V3_S0 |  | VCC_3V3_S0 |  | 236 | VCC_3V3_S3 |  | VCC_3V3_S3
237 | VCC_3V3_S0 |  | VCC_3V3_S0 |  | 238 | VCC_3V3_S3 |  | VCC_3V3_S3
239 | VCC_1V8_S0 |  | VCC_1V8_S0 |  | 240 | VCC_1V8_S3 |  | VCC_1V8_S3
241 | VCC_1V8_S0 |  | VCC_1V8_S0 |  | 242 | VCC_1V8_S3 |  | VCC_1V8_S3
243 | GND |  | GND |  | 244 | GND |  | GND
245 | GND |  | GND |  | 246 | GND |  | GND
247 | GND |  | GND |  | 248 | GND |  | GND
249 | GND |  | GND |  | 250 | GND |  | GND
251 | VCC5V_DCIN |  | VCC5V_DCIN |  | 252 | VCC5V_DCIN |  | VCC5V_DCIN
253 | VCC5V_DCIN |  | VCC5V_DCIN |  | 254 | VCC5V_DCIN |  | VCC5V_DCIN
255 | VCC5V_DCIN |  | VCC5V_DCIN |  | 256 | VCC5V_DCIN |  | VCC5V_DCIN
257 | VCC5V_DCIN |  | VCC5V_DCIN |  | 258 | VCC5V_DCIN |  | VCC5V_DCIN
259 | VCC5V_DCIN |  | VCC5V_DCIN |  | 260 | VCC5V_DCIN |  | VCC5V_DCIN
A28 | 114 | ETH1_RXD2_M1/SDMMC1_D0_M0/SAI3_SCLK_M1/I2C9_SDA_M1/SPI1_CLK_M0/PCIE1_CLKREQN_M1/PWM1_CH0_M1/GPIO1_B4_d | 1V8 |  |  |  |  |  |  | If not used, leave floating
B27 | 116 | ETH1_RXD3_M1/SDMMC1_D1_M0/SAI3_LRCK_M1/I2C9_SCL_M1/SPI1_MOSI_M0/PWM1_CH1_M1/GPIO1_B5_d | 1V8 |  |  |  |  |  |  | If not used, leave floating
1A23 | 118 | ETH1_RXCLK_M1/SDMMC1_D2_M0/SAI3_SDO_M1/UART3_CTSN_M2/SPI1_MISO_M0/PCIE0_CLKREQN_M1/GPIO1_B6_d | 1V8 |  |  |  |  |  |  | If not used, leave floating
A27 | 120 | ETH1_TXD2_M1/SDMMC1_D3_M0/SAI3_SDI_M1/UART3_RTSN_M2/SPI1_CSN0_M0/GPIO1_B7_d | 1V8 |  |  |  |  |  |  | If not used, leave floating
B26 | 122 | ETH1_TXD3_M1/SDMMC1_CMD_M0/PDM0_SDI2_M2/UART3_TX_M2/SPI1_CSN1_M0/PWM0_CH0_M1/GPIO1_C0_d | 1V8 |  |  |  |  |  |  | If not used, leave floating
1B22 | 124 | ETH1_TXCLK_M1/SDMMC1_CLK_M0/SAI3_MCLK_M1/PDM0_CLK0_M2/UART3_RX_M2/GPIO1_C1_d | 1V8 |  |  |  |  |  |  | If not used, leave floating
B29 | 126 | ETH1_PPSCLK_M1/SDMMC1_PWREN_M0/FSPI1_RSTN_M1/FSPI1_CSN1_M1/UART4_RTSN_M1/I2C6_SCL_M1/SPI2_CSN1_M1/PWM1_CH2_M1/GPIO1_C2_u | 1V8 |  |  |  |  |  |  | If not used, leave floating
1C23 | 128 | ETH1_PPSTRIG_M1/SDMMC1_DETN_M0/FSPI1_CSN0_M1/UART4_CTSN_M1/I2C6_SDA_M1/SPI2_CSN0_M1/GPIO1_C3_u | 1V8 |  |  |  |  |  |  | If not used, leave floating
1B23 | 130 | ETH1_TXD0_M1/FSPI1_D0_M1/UART4_TX_M1/UART2_RTSN_M0/SPI2_MOSI_M1/PCIE0_BUTTONRSTN/GPIO1_C4_d | 1V8 |  |  |  |  |  |  | If not used, leave floating
B28 | 132 | ETH1_TXD1_M1/FSPI1_D1_M1/UART4_RX_M1/UART2_CTSN_M0/SPI2_MISO_M1/PCIE1_BUTTONRSTN/GPIO1_C5_d | 1V8 |  |  |  |  |  |  | If not used, leave floating
1C22 | 134 | ETH1_RXD0_M1/FSPI1_D3_M1/PDM0_SDI1_M2/UART2_RX_M0/I2C8_SDA_M1/SATA_CPDET/GPIO1_C7_d | 1V8 |  |  |  |  |  |  | If not used, leave floating
1E22 | 136 | ETH_CLK1_25M_OUT_M1/FSPI1_CLK_M1/PDM0_CLK1_M2/SPDIF_TX1_M2/UART10_CTSN_M1/I2C5_SDA_M1/SPI2_CLK_M1/SATA_MPSWIT/CLK1_32K_OUT/GPIO1_D5_d | 1V8 |  |  |  |  |  |  | If not used, leave floating
1E21 | 138 | ETH1_MCLK_M1/SAI2_MCLK_M0/PDM0_SDI3_M2/SPDIF_RX1_M2/UART10_RTSN_M1/I2C5_SCL_M1/GPIO1_D4_d | 1V8 |  |  |  |  |  |  | If not used, leave floating
 | 140 | RTC_BAT | -
1E15 | 142 | CAM_CLK2_OUT_M1/ETH1_MCLK_M0/ETH_CLK0_25M_OUT_M1/SAI0_SDO3_M0/SPDIF_TX0_M2/UART9_CTSN_M0/SPI3_CSN1_M0/PWM2_CH7_M2/GPIO2_D7_d | 3V3 |  |  |  |  |  |  | If not used, leave floating
1A20 | 144 | VI_CIF_CLKO/ETH1_PPSCLK_M0/ETH0_RXCTL_M1/SAI3_SDO_M2/SPDIF_RX1_M1/UART3_CTSN_M0/SPI3_MISO_M0/CAN1_TX_M3/MIPI_TE_M1/GPIO3_A2_d | 3V3 |  |  |  |  |  |  | If not used, leave floating
B24 | 146 | SDMMC0_D0/FSPI1_D0_M0/DSM_AUD_LP_M0/UART0_RX_M1/UART7_RX_M2/I2C8_SCL_M0/SPI0_MOSI_M1/CAN0_RX_M0/PWM2_CH2_M0/GPIO2_A0_d | 3V3 |  |  |  |  |  |  | If not used, leave floating
B25 | 148 | SDMMC0_D1/FSPI1_D1_M0/DSM_AUD_LN_M0/SAI3_MCLK_M3/UART0_TX_M1/UART7_TX_M2/I2C8_SDA_M0/SPI0_MISO_M1/CAN0_TX_M0/PWM2_CH3_M0/GPIO2_A1_d | 3V3 |  |  |  |  |  |  | If not used, leave floating
A23 | 150 | SDMMC0_D2/FSPI1_D2_M0/DSM_AUD_RP_M0/SAI3_LRCK_M3/JTAG_TCK_M0/UART5_RTSN_M2/SPI0_CSN1_M1/CAN1_RX_M0/I3C1_SCL_M1/GPIO2_A2_d | 3V3 |  |  |  |  |  |  | If not used, leave floating
B23 | 152 | SDMMC0_D3/FSPI1_D3_M0/DSM_AUD_RN_M0/SAI3_SDI_M3/JTAG_TMS_M0/UART5_CTSN_M2/CAN1_TX_M0/I3C1_SDA_M1/GPIO2_A3_d | 3V3 |  |  |  |  |  |  | If not used, leave floating
1A21 | 154 | SDMMC0_CMD/FSPI1_CSN0_M0/SAI3_SDO_M3/UART5_RX_M2/I2C5_SDA_M0/SPI0_CSN0_M1/PWM2_CH4_M0/GPIO2_A4_d | 3V3 |  |  |  |  |  |  | If not used, leave floating
1B21 | 156 | SDMMC0_CLK/FSPI1_CLK_M0/SAI3_SCLK_M3/TEST_CLK_OUT/UART5_TX_M2/I2C5_SCL_M0/SPI0_CLK_M1/I3C1_SDA_PU_M1/GPIO2_A5_d | 3V3 |  |  |  |  |  |  | If not used, leave floating
1D12 | 158 | VO_LCDC_D12/VO_EBC_SDDO12/ETH0_PPSTRIG_M0/SAI1_SDI0_M1/DSMC_DQS0/FLEXBUS1_D10/FLEXBUS1_CSN_M0/UART2_RX_M2/UART3_CTSN_M1/I2C4_SDA_M3/GPIO3_B7_d | 1V8 |  |  |  |  |  |  | If not used, leave floating
1E9 | 160 | VO_LCDC_D11/VO_EBC_SDDO11/ETH0_PPSCLK_M0/SAI1_SDO3_M1/DSMC_DATA7/FLEXBUS1_D9/UART2_TX_M2/UART3_RTSN_M1/I2C4_SCL_M3/GPIO3_C0_d | 1V8 |  |  |  |  |  |  | If not used, leave floating
1B10 | 162 | VO_LCDC_D10/VO_EBC_SDDO10/ETH0_PTP_REFCLK_M0/SAI1_SDO2_M1/DSMC_DATA6/FLEXBUS1_D8/UART11_RX_M0/SPI2_MISO_M2/I2C5_SDA_M3/CAN0_RX_M3/GPIO3_C1_d | 1V8 |  |  |  |  |  |  | If not used, leave floating
1D9 | 164 | VO_LCDC_D7/VO_EBC_SDDO7/SAI1_SDO1_M1/DSMC_DATA5/FLEXBUS1_D7/UART11_TX_M0/SPI2_CSN0_M2/I2C5_SCL_M3/CAN0_TX_M3/GPIO3_C4_d | 1V8 |  |  |  |  |  |  | If not used, leave floating
1B9 | 166 | VO_LCDC_D6/VO_EBC_SDDO6/SAI1_SDO0_M1/DSMC_DATA4/FLEXBUS1_D6/UART8_RX_M0/SPI1_MISO_M2/PWM2_CH2_M3/GPIO3_C5_d | 1V8 |  |  |  |  |  |  | If not used, leave floating
1D7 | 168 | VO_LCDC_D5/VO_EBC_SDDO5/SAI1_LRCK_M1/DSMC_DATA3/FLEXBUS1_D5/UART8_TX_M0/SPI1_MOSI_M2/GPIO3_C6_d | 1V8 |  |  |  |  |  |  | If not used, leave floating
1C7 | 170 | VO_LCDC_D4/VO_EBC_SDDO4/SAI1_SCLK_M1/DSMC_DATA2/FLEXBUS1_D4/UART8_RTSN_M0/SPI1_CLK_M2/GPIO3_C7_d | 1V8 |  |  |  |  |  |  | If not used, leave floating
1C12 | 172 | VO_LCDC_D3/VO_EBC_SDDO3/SAI1_MCLK_M1/DSMC_DATA1/FLEXBUS1_D3/UART8_CTSN_M0/SPI1_CSN0_M2/PWM2_CH3_M3/GPIO3_D0_d | 1V8 |  |  |  |  |  |  | If not used, leave floating
1000000000000 | 174 | VO_LCDC_DEN/VO_EBC_SDLE/SAI1_SDI1_M1/DSMC_DATA0/FLEXBUS1_D1/UART5_RX_M0/SPI3_CLK_M1/I2C3_SCL_M2/GPIO3_D4_d | 1V8 |  |  |  |  |  |  | If not used, leave floating
1D10 | 176 | VO_LCDC_HSYNC/VO_EBC_GDCLK/SAI1_SDI2_M1/DSMC_CLKP/FLEXBUS1_D0/UART5_TX_M0/SPI3_MISO_M1/I2C3_SDA_M2/GPIO3_D5_d | 1V8 |  |  |  |  |  |  | If not used, leave floating
1C10 | 178 | VO_LCDC_VSYNC/VO_EBC_SDCLK/SAI1_SDI3_M1/DSMC_CLKN/FLEXBUS1_CLK/UART5_CTSN_M0/SPI3_MOSI_M1/PWM2_CH6_M3/GPIO3_D6_d | 1V8 |  |  |  |  |  |  | If not used, leave floating
1E7 | 180 | VO_LCDC_CLK/VO_EBC_SDOE/CAM_CLK0_OUT_M0/SAI4_SCLK_M1/DSMC_RESETN/FLEXBUS0_D15_M0/FLEXBUS1_D12_M0/FLEXBUS1_CSN_M1/UART5_RTSN_M0/SPI3_CSN1_M1/PWM2_CH7_M3/GPIO3_D7_d | 1V8 |  |  |  |  |  |  | If not used, leave floating
1B12 | 182 | SPDIF_RX0_M1/CAM_CLK1_OUT_M0/SAI4_LRCK_M1/DSMC_INT0/FLEXBUS0_D13_M0/FLEXBUS1_D14_M0/FLEXBUS1_CSN_M3/UART3_TX_M1/SPI1_CSN1_M2/I2C7_SCL_M2/MIPI_TE_M2/GPIO4_A0_d | 1V8 |  |  |  |  |  |  | If not used, leave floating
1B7 | 184 | VO_POST_EMPTY/SPDIF_TX0_M1/CAM_CLK2_OUT_M0/SAI4_SDO_M1/DSMC_INT2/FLEXBUS0_D14_M0/FLEXBUS1_D13_M0/FLEXBUS0_CSN_M1/UART3_RX_M1/I2C7_SDA_M2/GPIO4_A1_d | 1V8 |  |  |  |  |  |  | If not used, leave floating
 | 186 | GND
1D6 | 188 | SAI1_MCLK_M0/SAI4_MCLK_M0/AUPLL_CLK_IN_M2/PWM2_CH5_M0/GPIO4_A2_d | 3V3 |  |  |  |  |  |  | If not used, leave floating
1B6 | 190 | SAI1_LRCK_M0/FLEXBUS1_D12_M1/SPI4_CSN1_M2/UART5_CTSN_M1/I2C2_SDA_M2/PCIE1_CLKREQN_M2/GPIO4_A5_d | 3V3 |  |  |  |  |  |  | If not used, leave floating
1C6 | 192 | SAI1_SCLK_M0/FLEXBUS1_CSN_M4/SPI3_CSN0_M2/UART5_RTSN_M1/I2C2_SCL_M2/PWM2_CH4_M1/GPIO4_A3_d | 3V3 |  |  |  |  |  |  | If not used, leave floating
1B5 | 194 | SAI4_LRCK_M0/PDM1_CLK0_M1/FLEXBUS0_D14_M1/SPI3_MISO_M2/UART6_RX_M0/I2C4_SDA_M1/CAN0_RX_M2/GPIO4_A6_d | 3V3 |  |  |  |  |  |  | If not used, leave floating
1C5 | 196 | SAI4_SCLK_M0/PDM1_SDI3_M1/FLEXBUS0_D13_M1/SPI3_MOSI_M2/UART6_TX_M0/I2C4_SCL_M1/CAN0_TX_M2/GPIO4_A4_d | 3V3 |  |  |  |  |  |  | If not used, leave floating
A7 | 198 | SAI1_SDO0_M0/SAI4_SDI_M0/SPI3_CLK_M2/PWM2_CH6_M0/GPIO4_A7_d | 3V3 |  |  |  |  |  |  | If not used, leave floating
1A5 | 200 | SAI1_SDO1_M0/SAI1_SDI3_M0/PDM1_CLK1_M1/FLEXBUS1_D13_M1/SPI4_CLK_M2/UART5_TX_M1/UART6_RTSN_M0/UART2_RTSN_M1/GPIO4_B0_d | 3V3 |  |  |  |  |  |  | If not used, leave floating
B7 | 202 | SAI1_SDO2_M0/SAI1_SDI2_M0/PDM1_SDI2_M1/FLEXBUS1_D14_M1/SPI4_MOSI_M2/UART5_RX_M1/UART6_CTSN_M0/UART2_CTSN_M1/GPIO4_B1_d | 3V3 |  |  |  |  |  |  | If not used, leave floating
B6 | 204 | SAI1_SDO3_M0/SAI1_SDI1_M0/PDM1_SDI1_M1/FLEXBUS1_D15_M1/SPI4_MISO_M2/MIPI_TE_M0/GPIO4_B2_d | 3V3 |  |  |  |  |  |  | If not used, leave floating
1A6 | 206 | SAI1_SDI0_M0/SAI4_SDO_M0/PDM1_SDI0_M1/SPI4_CSN0_M2/SPI3_CSN1_M2/PWM2_CH7_M0/GPIO4_B3_d | 3V3 |  |  |  |  |  |  | If not used, leave floating
B8 | 208 | SPDIF_RX0_M0/FLEXBUS0_CSN_M4/UART2_RX_M1/I2C3_SDA_M0/CAN1_RX_M2/GPIO4_B4_d | 3V3 |  |  |  |  |  |  | If not used, leave floating
1A4 | 210 | SPDIF_TX0_M0/FLEXBUS0_D15_M1/UART2_TX_M1/I2C3_SCL_M0/PCIE0_CLKREQN_M2/CAN1_TX_M2/GPIO4_B5_d | 3V3 |  |  |  |  |  |  | If not used, leave floating
 | 212 | GND
A25 | 214 | SARADC_IN0_BOOT | 1V8 |  |  |  |  |  |  | Must connected to two resistor divide
1A22 | 216 | SARADC_IN1 | 1V8 |  |  |  |  |  |  | Connected to 1.8V through a 10kohm 1% Resistor
1C19 | 218 | SARADC_IN3 | 1V8 |  |  |  |  |  |  | If not used, leave floating
1E18 | 220 | SARADC_IN4 | 1V8 |  |  |  |  |  |  | If not used, leave floating
1D19 | 222 | SARADC_IN5 | 1V8 |  |  |  |  |  |  | If not used, leave floating
1D21 | 224 | SARADC_IN6 | 1V8 |  |  |  |  |  |  | If not used, leave floating
1E19 | 226 | SARADC_IN7 | 1V8 |  |  |  |  |  |  | If not used, leave floating
 | 228 | GND
PMIC | 230 | PMIC_EXT_EN_OUT
 | 232 | PWRON_L
 | 234 | 32KOUT_RTC2WIFI | 3V3
 | 236 | VCC_1V8_S0
 | 238 | VCC_1V8_S0
 | 240 | VCC_1V8_S3
 | 242 | VCC_1V8_S3
 | 244 | GND
 | 246 | GND
 | 248 | GND
 | 250 | GND
 | 252 | VCC5V_DCIN
 | 254 | VCC5V_DCIN
 | 256 | VCC5V_DCIN
 | 258 | VCC5V_DCIN
 | 260 | VCC5V_DCIN

Sheet: 工作表1
Pin Number | Pin Name | IO Power domain | Omni3576 Definition |  | Pin Number | Pin Name | IO Power domain | Omni3576 Definition
1 | GND |  | GND |  | 2 | GND |  | GND
3 | USB2_OTG0_DP | - | USB2_OTG0_DP | USB3.0 | 4 | USB2_OTG0_ID | - | NC
5 | USB2_OTG0_DM | - | USB2_OTG0_DM |  | 6 | USB2_OTG0_VBUSDET | - | USB2_OTG0_VBUSDET | USB2
7 | USB3_OTG0_SSRX1P/DP_TX_D0P | - | USB3_OTG0_SSRX1P |  | 8 | USB2_OTG1_DP | - | USB2_HOST1_DP
9 | USB3_OTG0_SSRX1N/DP_TX_D0N | - | USB3_OTG0_SSRX1N |  | 10 | USB2_OTG1_DM | - | USB2_HOST1_DM
11 | USB3_OTG0_SSTX1P/DP_TX_D1P | - | USB3_OTG0_SSTX1P |  | 12 | GND |  | GND
13 | USB3_OTG0_SSTX1N/DP_TX_D1N | - | USB3_OTG0_SSTX1N |  | 14 | NPOR |  | RESET_L
15 | USB3_OTG0_SSRX2P/DP_TX_D2P | - | USB3_OTG0_SSRX2N |  | 16 | REF_CLK0_OUT/AUPLL_CLK_IN_M0/GPIO0_A0_d | 1V8 | REF_CLK0_OUT | USB2_HUB_RST
17 | USB3_OTG0_SSRX2N/DP_TX_D2N | - | USB3_OTG0_SSRX2P |  | 18 | SDMMC0_DETN/SPI2_CSN1_M0/GPIO0_A7_u | 1V8 | SDMMC0_DET_L | TF
19 | USB3_OTG0_SSTX2P/DP_TX_D3P | - | USB3_OTG0_SSTX2P |  | 20 | AUPLL_CLK_IN_M1/SPI2_CSN0_M0/I2C0_SCL_M0/GPIO0_B0_z | 1V8 | WIFI_WAKE_HOST_H | WIFI
21 | USB3_OTG0_SSTX2N/DP_TX_D3N | - | USB3_OTG0_SSTX2N |  | 22 | SPI2_MISO_M0/I2C0_SDA_M0/GPIO0_B1_z | 1V8 | BT_WAKE_HOST_H
23 | GND |  | GND |  | 24 | REF_CLK1_OUT/I2C1_SCL_M1/UART4_TX_M2/PWM1_CH0_M0/GPIO0_B4_d | 3V3 | GPIO_16
25 | MIPI_DPHY_DSI_TX_D0N/MIPI_CPHY_DSI_TX_TRIO0_A | - | MIPI_DPHY_DSI_TX_D0N | DSI | 26 | REF_CLK2_OUT/I2C1_SDA_M1/UART4_RX_M2/PWM1_CH1_M0/GPIO0_B5_d | 3V3 | GPIO_15
27 | MIPI_DPHY_DSI_TX_D0P/MIPI_CPHY_DSI_TX_TRIO0_B | - | MIPI_DPHY_DSI_TX_D0P |  | 28 | SDMMC0_PWREN/SDMMC1_DETN_M2/HDMI_TX_HPDIN_M1/EDP_TX_HPDIN_M1/PWM1_CH2_M0/GPIO0_B6_d | 3V3 | SDMMC0_PWREN_H | TF
29 | MIPI_DPHY_DSI_TX_D1N/MIPI_CPHY_DSI_TX_TRIO0_C | - | MIPI_DPHY_DSI_TX_D1N |  | 30 | I2C2_SCL_M0/UART1_TX_M0/NPU_AVS/PWM1_CH4_M0/GPIO0_B7_d | 3V3 | I2C2_SCL_M0_CC_RTC | USB-C+AUDIO
31 | MIPI_DPHY_DSI_TX_D1P/MIPI_CPHY_DSI_TX_TRIO1_A | - | MIPI_DPHY_DSI_TX_D1P |  | 32 | I2C2_SDA_M0/UART1_RX_M0/CPULIT_AVS/PWM1_CH3_M0/GPIO0_C0_d | 3V3 | I2C2_SDA_M0_CC_RTC
33 | MIPI_DPHY_DSI_TX_CLKN/MIPI_CPHY_DSI_TX_TRIO1_B | - | MIPI_DPHY_DSI_TX_CLKN |  | 34 | I2C0_SCL_M1/UART8_TX_M2/I3C0_SCL_M0/GPIO0_C1_d | 3V3 | GPIO_5
35 | MIPI_DPHY_DSI_TX_CLKP/MIPI_CPHY_DSI_TX_TRIO1_C | - | MIPI_DPHY_DSI_TX_CLKP |  | 36 | I2C0_SDA_M1/UART8_RX_M2/I3C0_SDA_M0/GPIO0_C2_d | 3V3 | GPIO_3
37 | MIPI_DPHY_DSI_TX_D2N/MIPI_CPHY_DSI_TX_TRIO2_A | - | MIPI_DPHY_DSI_TX_D2N |  | 38 | PDM0_CLK1_M0/HDMI_TX_CEC_M1/SPI0_CSN1_M0/PWM0_CH1_M0/GPIO0_C3_d | 3V3 | GPIO_26
39 | MIPI_DPHY_DSI_TX_D2P/MIPI_CPHY_DSI_TX_TRIO2_B | - | MIPI_DPHY_DSI_TX_D2P |  | 40 | SAI0_MCLK_M1/PDM0_CLK0_M0/UART10_TX_M2/PWM0_CH0_M0/GPIO0_C4_d | 3V3 | PWM0_CH0_M0_IR | IR
41 | MIPI_DPHY_DSI_TX_D3N/MIPI_CPHY_DSI_TX_TRIO2_C | - | MIPI_DPHY_DSI_TX_D3N |  | 42 | SAI0_SDO0_M1/DP_HPDIN_M1/UART10_RX_M2/I3C0_SDA_PU_M0/GPIO0_C5_d | 3V3 | GPIO_18
43 | MIPI_DPHY_DSI_TX_D3P/NO_USE | - | MIPI_DPHY_DSI_TX_D3P |  | 44 | SAI0_SCLK_M1/I2C3_SCL_M1/SPI0_CSN0_M0/GPIO0_C6_d | 3V3 | GPIO_24
45 | GND |  | GND |  | 46 | SAI0_LRCK_M1/I2C3_SDA_M1/SPI0_CLK_M0/GPIO0_C7_d | 3V3 | GPIO_23
47 | MIPI_DPHY_CSI0_RX_D0N/MIPI_CPHY_CSI_RX_TRIO0_A | - | MIPI_DPHY_CSI0_RX_D0N | CSI0 | 48 | SAI0_SDI0_M1/PDM0_SDI0_M0/SPI0_MOSI_M0/GPIO0_D0_d | 3V3 | GPIO_19
49 | MIPI_DPHY_CSI0_RX_D0P/MIPI_CPHY_CSI_RX_TRIO0_B | - | MIPI_DPHY_CSI0_RX_D0P |  | 50 | SAI0_SDI1_M1/SAI0_SDO3_M1/PDM0_SDI1_M0/SPI0_MISO_M0/GPIO0_D1_d | 3V3 | GPIO_21
51 | MIPI_DPHY_CSI0_RX_D1N/MIPI_CPHY_CSI_RX_TRIO0_C | - | MIPI_DPHY_CSI0_RX_D1N |  | 52 | SAI0_SDI2_M1/SAI0_SDO2_M1/PDM0_SDI2_M0/I2C4_SCL_M0/CPUBIG_AVS/PWM1_CH5_M0/UART1_CTSN_M0/GPIO0_D2_d | 3V3 | PCIE0_WAKEn_M0 | M.2
53 | MIPI_DPHY_CSI0_RX_D1P/MIPI_CPHY_CSI_RX_TRIO1_A | - | MIPI_DPHY_CSI0_RX_D1P |  | 54 | SAI0_SDI3_M1/SAI0_SDO1_M1/PDM0_SDI3_M0/I2C4_SDA_M0/GPU_AVS/PWM2_CH0_M0/UART1_RTSN_M0/GPIO0_D3_d | 3V3 | GPIO_12
55 | MIPI_DPHY_CSI0_RX_CLKN/MIPI_CPHY_CSI_RX_TRIO1_B | - | MIPI_DPHY_CSI0_RX_CLKN |  | 56 | UART0_TX_M0/JTAG_TCK_M1/GPIO0_D4_u | 3V3 | UART0_TX_M0_DEBUG | DEBUG
57 | MIPI_DPHY_CSI0_RX_CLKP/MIPI_CPHY_CSI_RX_TRIO1_C | - | MIPI_DPHY_CSI0_RX_CLKP |  | 58 | UART0_RX_M0/JTAG_TMS_M1/GPIO0_D5_u | 3V3 | UART0_RX_M0_DEBUG
59 | MIPI_DPHY_CSI0_RX_D2N/MIPI_CPHY_CSI_RX_TRIO2_A | - | MIPI_DPHY_CSI0_RX_D2N |  | 60 | GND |  | GND
61 | MIPI_DPHY_CSI0_RX_D2P/MIPI_CPHY_CSI_RX_TRIO2_B | - | MIPI_DPHY_CSI0_RX_D2P |  | 62 | HDMI_TX_SBDN/EDP_TX_AUXN | - | HDMI_TX_SBDN | HDMI
63 | MIPI_DPHY_CSI0_RX_D3N/MIPI_CPHY_CSI_RX_TRIO2_C | - | MIPI_DPHY_CSI0_RX_D3N |  | 64 | HDMI_TX_SBDP/EDP_TX_AUXP | - | HDMI_TX_SBDP
65 | MIPI_DPHY_CSI0_RX_D3P/NO_USE | - | MIPI_DPHY_CSI0_RX_D3P |  | 66 | DSM_AUD_LP_M1/SAI4_MCLK_M2/HDMI_TX_CEC_M0/I2C7_SCL_M3/SPI4_CSN1_M0/UART11_TX_M2/PWM1_CH5_M1/GPIO4_C0_d | 3V3 | HDMI_TX_CEC_PORT
67 | GND |  | GND |  | 68 | DSM_AUD_LN_M1/HDMI_TX_HPDIN_M0/PCIE1_CLKREQN_M3/I2C7_SDA_M3/EDP_TX_HPDIN_M0/UART11_RX_M2/PWM0_CH1_M1/GPIO4_C1_d | 3V3 | HDMITX_HPDIN/HDMITX_SBDN
69 | HDMI_TX_D3N/EDP_TX_D3N | - | HDMI_TX_D3N | HDMI | 70 | DSM_AUD_RP_M1/HDMI_TX_SCL/I2C2_SCL_M3/CAN0_TX_M1/UART9_TX_M2/PWM2_CH0_M1/GPIO4_C2_d | 3V3 | HDMI_TX_SCL_PORT
71 | HDMI_TX_D3P/EDP_TX_D3P | - | HDMI_TX_D3P |  | 72 | DSM_AUD_RN_M1/HDMI_TX_SDA/I2C2_SDA_M3/CAN0_RX_M1/UART9_RX_M2/PWM2_CH1_M1/GPIO4_C3_d | 3V3 | HDMI_TX_SDA_PORT
73 | HDMI_TX_D0N/EDP_TX_D0N | - | HDMI_TX_D0N |  | 74 | ISP_PRELIGHT_TRIG_M1/SAI4_LRCK_M2/DP_HPDIN_M0/I2C3_SCL_M3/SPI4_CSN0_M0/UART6_TX_M3/PWM2_CH6_M1/GPIO4_C4_d | 3V3 | TYPEC_DPTX_AUX_PUPDCTL1 | USB-C
75 | HDMI_TX_D0P/EDP_TX_D0P | - | HDMI_TX_D0P |  | 76 | ISP_FLASH_TRIGOUT_M1/SAI4_SDO_M2/VP0_SYNC_OUT/SATA1_ACTLED_M1/I2C3_SDA_M3/SPI4_MOSI_M0/UART6_RX_M3/PWM2_CH5_M1/GPIO4_C5_d | 3V3 | TYPEC_DPTX_AUX_PUPDCTL2
77 | HDMI_TX_D1N/EDP_TX_D1N | - | HDMI_TX_D1N |  | 78 | SAI4_SDI_M2/VP1_SYNC_OUT/PCIE0_CLKREQN_M3/SATA0_ACTLED_M1/I2C6_SCL_M3/SPI4_MISO_M0/CAN1_TX_M1/PWM2_CH2_M1/GPIO4_C6_d | 3V3 | HDMI_TX_ON_H | HDMI
79 | HDMI_TX_D1P/EDP_TX_D1P | - | HDMI_TX_D1P |  | 80 | SAI4_SCLK_M2/VP2_SYNC_OUT/I2C6_SDA_M3/SPI4_CLK_M0/CAN1_RX_M1/PWM2_CH3_M1/GPIO4_C7_d | 3V3 | GPIO_31
81 | HDMI_TX_D2N/EDP_TX_D2N | - | HDMI_TX_D2N |  | 82 | DP_TX_AUXP | - | DP_TX_AUXP | USB-C
83 | HDMI_TX_D2P/EDP_TX_D2P | - | HDMI_TX_D2P |  | 84 | DP_TX_AUXN | - | DP_TX_AUXN
85 | GND |  | GND |  | 86 | MIPI_DPHY_CSI1_RX_CLKN | - | MIPI_DPHY_CSI1_RX_CLKN | CSI1
87 | MIPI_DPHY_CSI1_RX_D3N/MIPI_DPHY_CSI2_RX_D1N | - | MIPI_DPHY_CSI1_RX_D3N | CSI1 | 88 | MIPI_DPHY_CSI1_RX_CLKP | - | MIPI_DPHY_CSI1_RX_CLKP
89 | MIPI_DPHY_CSI1_RX_D3P/MIPI_DPHY_CSI2_RX_D1P | - | MIPI_DPHY_CSI1_RX_D3P |  | 90 | MIPI_DPHY_CSI2_RX_CLKN | - | NC
91 | MIPI_DPHY_CSI1_RX_D2N/MIPI_DPHY_CSI2_RX_D0N | - | MIPI_DPHY_CSI1_RX_D2N |  | 92 | MIPI_DPHY_CSI2_RX_CLKP | - | NC
93 | MIPI_DPHY_CSI1_RX_D2P/MIPI_DPHY_CSI2_RX_D0P | - | MIPI_DPHY_CSI1_RX_D2P |  | 94 | MIPI_DPHY_CSI4_RX_CLKN | - | NC
95 | MIPI_DPHY_CSI1_RX_D1N | - | MIPI_DPHY_CSI1_RX_D1N |  | 96 | MIPI_DPHY_CSI4_RX_CLKP | - | NC
97 | MIPI_DPHY_CSI1_RX_D1P | - | MIPI_DPHY_CSI1_RX_D1P |  | 98 | GND |  | GND
99 | MIPI_DPHY_CSI1_RX_D0N | - | MIPI_DPHY_CSI1_RX_D0N |  | 100 | PCIE0_REFCLKP | - | PCIE0_REFCLKP | PCIE
101 | MIPI_DPHY_CSI1_RX_D0P | - | MIPI_DPHY_CSI1_RX_D0P |  | 102 | PCIE0_REFCLKN | - | PCIE0_REFCLKN
103 | GND |  | GND |  | 104 | PCIE1_REFCLKP | - | NC
105 | PCIE0_RXP/SATA0_RXP | - | PCIE0_RXP | M.2 | 106 | PCIE1_REFCLKN | - | NC
107 | PCIE0_RXN/SATA0_RXN | - | PCIE0_RXN |  | 108 | MIPI_DPHY_CSI3_RX_CLKN | - | NC
109 | PCIE0_TXP/SATA0_TXP | - | PCIE0_TXN |  | 110 | MIPI_DPHY_CSI3_RX_CLKP | - | NC
111 | PCIE0_TXN/SATA0_TXN | - | PCIE0_TXP |  | 112 | GND |  | GND
113 | GND |  | GND |  | 114 | ETH1_RXD2_M1/SDMMC1_D0_M0/SAI3_SCLK_M1/I2C9_SDA_M1/SPI1_CLK_M0/PCIE1_CLKREQN_M1/PWM1_CH0_M1/GPIO1_B4_d | 1V8 | SDMMC1_D0_M0 | WIFI
115 | PCIE1_TXP/SATA1_TXP/USB3_OTG1_SSTXP | - | USB3_HOST1_SSTXP | USB3_1 | 116 | ETH1_RXD3_M1/SDMMC1_D1_M0/SAI3_LRCK_M1/I2C9_SCL_M1/SPI1_MOSI_M0/PWM1_CH1_M1/GPIO1_B5_d | 1V8 | SDMMC1_D1_M0
117 | PCIE1_TXN/SATA1_TXN/USB3_OTG1_SSTXN | - | USB3_HOST1_SSTXN |  | 118 | ETH1_RXCLK_M1/SDMMC1_D2_M0/SAI3_SDO_M1/UART3_CTSN_M2/SPI1_MISO_M0/PCIE0_CLKREQN_M1/GPIO1_B6_d | 1V8 | SDMMC1_D2_M0
119 | PCIE1_RXP/SATA1_RXP/USB3_OTG1_SSRXP | - | USB3_HOST1_SSRXP |  | 120 | ETH1_TXD2_M1/SDMMC1_D3_M0/SAI3_SDI_M1/UART3_RTSN_M2/SPI1_CSN0_M0/GPIO1_B7_d | 1V8 | SDMMC1_D3_M0
121 | PCIE1_RXN/SATA1_RXN/USB3_OTG1_SSRXN | - | USB3_HOST1_SSRXN |  | 122 | ETH1_TXD3_M1/SDMMC1_CMD_M0/PDM0_SDI2_M2/UART3_TX_M2/SPI1_CSN1_M0/PWM0_CH0_M1/GPIO1_C0_d | 1V8 | SDMMC1_CMD_M0
123 | GND |  | GND |  | 124 | ETH1_TXCLK_M1/SDMMC1_CLK_M0/SAI3_MCLK_M1/PDM0_CLK0_M2/UART3_RX_M2/GPIO1_C1_d | 1V8 | SDMMC1_CLK_M0
125 | MIPI_DPHY_CSI3_RX_D3N/MIPI_DPHY_CSI4_RX_D1N | - | NC |  | 126 | ETH1_PPSCLK_M1/SDMMC1_PWREN_M0/FSPI1_RSTN_M1/FSPI1_CSN1_M1/UART4_RTSN_M1/I2C6_SCL_M1/SPI2_CSN1_M1/PWM1_CH2_M1/GPIO1_C2_u | 1V8 | UART4_RTSN_M1
127 | MIPI_DPHY_CSI3_RX_D3P/MIPI_DPHY_CSI4_RX_D1P | - | NC |  | 128 | ETH1_PPSTRIG_M1/SDMMC1_DETN_M0/FSPI1_CSN0_M1/UART4_CTSN_M1/I2C6_SDA_M1/SPI2_CSN0_M1/GPIO1_C3_u | 1V8 | UART4_CTSN_M1
129 | MIPI_DPHY_CSI3_RX_D2N/MIPI_DPHY_CSI4_RX_D0N | - | NC |  | 130 | ETH1_TXD0_M1/FSPI1_D0_M1/UART4_TX_M1/UART2_RTSN_M0/SPI2_MOSI_M1/PCIE0_BUTTONRSTN/GPIO1_C4_d | 1V8 | UART4_TX_M1
131 | MIPI_DPHY_CSI3_RX_D2P/MIPI_DPHY_CSI4_RX_D0P | - | NC |  | 132 | ETH1_TXD1_M1/FSPI1_D1_M1/UART4_RX_M1/UART2_CTSN_M0/SPI2_MISO_M1/PCIE1_BUTTONRSTN/GPIO1_C5_d | 1V8 | UART4_RX_M1
133 | MIPI_DPHY_CSI3_RX_D1N | - | NC |  | 134 | ETH1_RXD0_M1/FSPI1_D3_M1/PDM0_SDI1_M2/UART2_RX_M0/I2C8_SDA_M1/SATA_CPDET/GPIO1_C7_d | 1V8 | BT_REG_ON_H | USB2
135 | MIPI_DPHY_CSI3_RX_D1P | - | NC |  | 136 | ETH_CLK1_25M_OUT_M1/FSPI1_CLK_M1/PDM0_CLK1_M2/SPDIF_TX1_M2/UART10_CTSN_M1/I2C5_SDA_M1/SPI2_CLK_M1/SATA_MPSWIT/CLK1_32K_OUT/GPIO1_D5_d | 1V8 | CLK1_32K_OUT_WIFI | ACT_LED
137 | MIPI_DPHY_CSI3_RX_D0N | - | NC |  | 138 | ETH1_MCLK_M1/SAI2_MCLK_M0/PDM0_SDI3_M2/SPDIF_RX1_M2/UART10_RTSN_M1/I2C5_SCL_M1/GPIO1_D4_d | 1V8 | HOST_WAKE_BT_H | WIFI
139 | MIPI_DPHY_CSI3_RX_D0P | - | NC |  | 140 | RTC_BAT | - | RTC_BAT | RTC
141 | GND |  | GND |  | 142 | CAM_CLK2_OUT_M1/ETH1_MCLK_M0/ETH_CLK0_25M_OUT_M1/SAI0_SDO3_M0/SPDIF_TX0_M2/UART9_CTSN_M0/SPI3_CSN1_M0/PWM2_CH7_M2/GPIO2_D7_d | 3V3 | GPIO_36
143 | ETH1_TXCTL_M1/FSPI1_D2_M1/PDM0_SDI0_M2/UART2_TX_M0/I2C8_SCL_M1/SATA_CPPOD/GPIO1_C6_d | 1V8 | WIFI_REG_ON_H | WIFI | 144 | VI_CIF_CLKO/ETH1_PPSCLK_M0/ETH0_RXCTL_M1/SAI3_SDO_M2/SPDIF_RX1_M1/UART3_CTSN_M0/SPI3_MISO_M0/CAN1_TX_M3/MIPI_TE_M1/GPIO3_A2_d | 3V3 | GPIO_11
145 | ETH1_RXCTL_M1/SAI2_SCLK_M0/UART10_RX_M1/I3C0_SDA_PU_M1/GPIO1_D1_d | 1V8 | SAI2_SCLK_M0 | WIFI | 146 | SDMMC0_D0/FSPI1_D0_M0/DSM_AUD_LP_M0/UART0_RX_M1/UART7_RX_M2/I2C8_SCL_M0/SPI0_MOSI_M1/CAN0_RX_M0/PWM2_CH2_M0/GPIO2_A0_d | 3V3 | SDMMC0_D0 | TF
147 | ETH1_MDIO_M1/SAI2_SDI_M0/I3C0_SDA_M1/PWM1_CH4_M1/GPIO1_D3_d | 1V8 | SAI2_SDI_M0 |  | 148 | SDMMC0_D1/FSPI1_D1_M0/DSM_AUD_LN_M0/SAI3_MCLK_M3/UART0_TX_M1/UART7_TX_M2/I2C8_SDA_M0/SPI0_MISO_M1/CAN0_TX_M0/PWM2_CH3_M0/GPIO2_A1_d | 3V3 | SDMMC0_D1
149 | ETH1_RXD1_M1/SAI2_SDO_M0/UART10_TX_M1/GPIO1_D0_d | 1V8 | SAI2_SDO_M0 |  | 150 | SDMMC0_D2/FSPI1_D2_M0/DSM_AUD_RP_M0/SAI3_LRCK_M3/JTAG_TCK_M0/UART5_RTSN_M2/SPI0_CSN1_M1/CAN1_RX_M0/I3C1_SCL_M1/GPIO2_A2_d | 3V3 | SDMMC0_D2
151 | ETH1_MDC_M1/SAI2_LRCK_M0/I3C0_SCL_M1/PWM1_CH3_M1/GPIO1_D2_d | 1V8 | SAI2_LRCK_M0 |  | 152 | SDMMC0_D3/FSPI1_D3_M0/DSM_AUD_RN_M0/SAI3_SDI_M3/JTAG_TMS_M0/UART5_CTSN_M2/CAN1_TX_M0/I3C1_SDA_M1/GPIO2_A3_d | 3V3 | SDMMC0_D3
153 | VI_CIF_D15/SDMMC1_D0_M1/ETH0_RXD0_M1/SAI0_SDO0_M0/UART8_TX_M1/SPI4_CSN1_M3/I2C4_SCL_M2/GPIO2_A6_d | 3V3 | GPIO_7 |  | 154 | SDMMC0_CMD/FSPI1_CSN0_M0/SAI3_SDO_M3/UART5_RX_M2/I2C5_SDA_M0/SPI0_CSN0_M1/PWM2_CH4_M0/GPIO2_A4_d | 3V3 | SDMMC0_CMD
155 | VI_CIF_CLKI/ETH1_PTP_REFCLK_M0/ETH0_RXD1_M1/SAI3_SDI_M2/SPDIF_TX1_M1/UART3_RTSN_M0/SPI3_CSN0_M0/CAN1_RX_M3/GPIO3_A3_d | 3V3 | GPIO_13 |  | 156 | SDMMC0_CLK/FSPI1_CLK_M0/SAI3_SCLK_M3/TEST_CLK_OUT/UART5_TX_M2/I2C5_SCL_M0/SPI0_CLK_M1/I3C1_SDA_PU_M1/GPIO2_A5_d | 3V3 | SDMMC0_CLK
157 | VI_CIF_D6/ETH0_RXD2_M1/SAI0_LRCK_M0/UART7_RX_M0/UART8_CTSN_M1/I2C8_SDA_M2/GPIO2_B7_d | 3V3 | GPIO_27 |  | 158 | VO_LCDC_D12/VO_EBC_SDDO12/ETH0_PPSTRIG_M0/SAI1_SDI0_M1/DSMC_DQS0/FLEXBUS1_D10/FLEXBUS1_CSN_M0/UART2_RX_M2/UART3_CTSN_M1/I2C4_SDA_M3/GPIO3_B7_d | 1V8 | I2C4_SDA_M3_MIPI_CAM0/2 | CSI1
159 | VI_CIF_D7/ETH1_PTP_REFCLK_M1/ETH0_RXD3_M1/SAI0_SCLK_M0/UART7_TX_M0/UART8_RTSN_M1/I2C8_SCL_M2/GPIO2_B6_d | 3V3 | GPIO_28 |  | 160 | VO_LCDC_D11/VO_EBC_SDDO11/ETH0_PPSCLK_M0/SAI1_SDO3_M1/DSMC_DATA7/FLEXBUS1_D9/UART2_TX_M2/UART3_RTSN_M1/I2C4_SCL_M3/GPIO3_C0_d | 1V8 | I2C4_SCL_M3_MIPI_CAM0/2
161 | VI_CIF_D8/SDMMC1_DETN_M1/ETH0_RXCLK_M1/SAI0_MCLK_M0/PDM0_CLK0_M3/UART7_RTSN_M0/SPI4_MISO_M3/SATA1_ACTLED_M0/GPIO2_B5_d | 3V3 | GPIO_22 |  | 162 | VO_LCDC_D10/VO_EBC_SDDO10/ETH0_PTP_REFCLK_M0/SAI1_SDO2_M1/DSMC_DATA6/FLEXBUS1_D8/UART11_RX_M0/SPI2_MISO_M2/I2C5_SDA_M3/CAN0_RX_M3/GPIO3_C1_d | 1V8 | I2C5_SDA_M3_MIPI_CAM1/HDMI_RX | DSI+CSI0
163 | VI_CIF_D14/SDMMC1_D1_M1/ETH0_TXCTL_M1/SAI0_SDO1_M0/UART8_RX_M1/I2C4_SDA_M2/GPIO2_A7_d | 3V3 | GPIO_29 |  | 164 | VO_LCDC_D7/VO_EBC_SDDO7/SAI1_SDO1_M1/DSMC_DATA5/FLEXBUS1_D7/UART11_TX_M0/SPI2_CSN0_M2/I2C5_SCL_M3/CAN0_TX_M3/GPIO3_C4_d | 1V8 | I2C5_SCL_M3_MIPI_CAM1/HDMI_RX
165 | VI_CIF_D12/SDMMC1_D3_M1/ETH0_TXD0_M1/SAI0_SDI1_M0/PDM0_SDI2_M3/UART1_RX_M1/GPIO2_B1_d | 3V3 | PCIE0_PERSTn | M.2 | 166 | VO_LCDC_D6/VO_EBC_SDDO6/SAI1_SDO0_M1/DSMC_DATA4/FLEXBUS1_D6/UART8_RX_M0/SPI1_MISO_M2/PWM2_CH2_M3/GPIO3_C5_d | 1V8 | DSI_IO1 | DSI
167 | VI_CIF_D13/SDMMC1_D2_M1/ETH0_TXD1_M1/SAI0_SDI0_M0/PDM0_SDI3_M3/UART1_TX_M1/GPIO2_B0_d | 3V3 | GPIO_37 |  | 168 | VO_LCDC_D5/VO_EBC_SDDO5/SAI1_LRCK_M1/DSMC_DATA3/FLEXBUS1_D5/UART8_TX_M0/SPI1_MOSI_M2/GPIO3_C6_d | 1V8 | CSI0_IO0 | CSI0
169 | GND |  | GND |  | 170 | VO_LCDC_D4/VO_EBC_SDDO4/SAI1_SCLK_M1/DSMC_DATA2/FLEXBUS1_D4/UART8_RTSN_M0/SPI1_CLK_M2/GPIO3_C7_d | 1V8 | CSI1_IO1 | CSI1
171 | VI_CIF_D3/ETH1_RXCLK_M0/ETH0_PPSTRIG_M1/SAI2_SCLK_M1/PDM1_SDI2_M0/UART11_CTSN_M1/SPI1_MOSI_M1/PWM1_CH2_M2/GPIO2_C2_d | 3V3 | GMAC1_RXCLK_M0 | GMAC1 | 172 | VO_LCDC_D3/VO_EBC_SDDO3/SAI1_MCLK_M1/DSMC_DATA1/FLEXBUS1_D3/UART8_CTSN_M0/SPI1_CSN0_M2/PWM2_CH3_M3/GPIO3_D0_d | 1V8 | CSI1_IO0
173 | VI_CIF_D0/ETH1_TXCLK_M0/SAI2_SDI_M1/PDM1_CLK0_M0/UART11_RX_M1/SPI1_CLK_M1/PWM1_CH4_M2/GPIO2_C5_d | 3V3 | GMAC1_TXCLK_M0 |  | 174 | VO_LCDC_DEN/VO_EBC_SDLE/SAI1_SDI1_M1/DSMC_DATA0/FLEXBUS1_D1/UART5_RX_M0/SPI3_CLK_M1/I2C3_SCL_M2/GPIO3_D4_d | 1V8 | USBC_INT | USB-C
175 | VI_CIF_HREF/ETH0_MDIO_M1/SAI3_SCLK_M2/UART3_TX_M0/SPI3_CLK_M0/I2C7_SCL_M1/GPIO3_A0_d | 3V3 | GPIO_32 |  | 176 | VO_LCDC_HSYNC/VO_EBC_GDCLK/SAI1_SDI2_M1/DSMC_CLKP/FLEXBUS1_D0/UART5_TX_M0/SPI3_MISO_M1/I2C3_SDA_M2/GPIO3_D5_d | 1V8 | USBC_PWR
177 | VI_CIF_VSYNC/ETH1_PPSTRIG_M0/ETH0_MDC_M1/SAI3_LRCK_M2/UART3_RX_M0/SPI3_MOSI_M0/I2C7_SDA_M1/GPIO3_A1_d | 3V3 | GPIO_33 |  | 178 | VO_LCDC_VSYNC/VO_EBC_SDCLK/SAI1_SDI3_M1/DSMC_CLKN/FLEXBUS1_CLK/UART5_CTSN_M0/SPI3_MOSI_M1/PWM2_CH6_M3/GPIO3_D6_d | 1V8 | FAN_PWM | FAN
179 | CAM_CLK1_OUT_M1/ETH_CLK1_25M_OUT_M0/ETH0_MCLK_M1/SAI3_MCLK_M2/SPDIF_RX0_M2/UART9_RTSN_M0/I3C1_SDA_PU_M0/PWM2_CH6_M2/GPIO2_D6_d | 3V3 | ETH_CLK1_25M_OUT_M0 | GMAC1 | 180 | VO_LCDC_CLK/VO_EBC_SDOE/CAM_CLK0_OUT_M0/SAI4_SCLK_M1/DSMC_RESETN/FLEXBUS0_D15_M0/FLEXBUS1_D12_M0/FLEXBUS1_CSN_M1/UART5_RTSN_M0/SPI3_CSN1_M1/PWM2_CH7_M3/GPIO3_D7_d | 1V8 | PCIE_PWR | M.2
181 | ISP_PRELIGHT_TRIG_M0/ETH1_MDC_M0/UART6_RTSN_M1/I2C9_SDA_M2/PWM2_CH4_M2/GPIO2_D4_d | 3V3 | GMAC1_MDC_M0 |  | 182 | SPDIF_RX0_M1/CAM_CLK1_OUT_M0/SAI4_LRCK_M1/DSMC_INT0/FLEXBUS0_D13_M0/FLEXBUS1_D14_M0/FLEXBUS1_CSN_M3/UART3_TX_M1/SPI1_CSN1_M2/I2C7_SCL_M2/MIPI_TE_M2/GPIO4_A0_d | 1V8 | M.2M_ALERT
183 | ISP_FLASH_TRIGOUT_M0/ETH1_MDIO_M0/UART6_CTSN_M1/I2C9_SCL_M2/PWM2_CH5_M2/GPIO2_D5_d | 3V3 | GMAC1_MDIO_M0 |  | 184 | VO_POST_EMPTY/SPDIF_TX0_M1/CAM_CLK2_OUT_M0/SAI4_SDO_M1/DSMC_INT2/FLEXBUS0_D14_M0/FLEXBUS1_D13_M0/FLEXBUS0_CSN_M1/UART3_RX_M1/I2C7_SDA_M2/GPIO4_A1_d | 1V8 | CSI0_IO1
185 | VI_CIF_D9/SDMMC1_PWREN_M1/ETH0_TXD2_M1/SAI0_SDI3_M0/PDM0_SDI0_M3/UART7_CTSN_M0/SPI4_MOSI_M3/SATA0_ACTLED_M0/GPIO2_B4_d | 3V3 | GMAC1_RSTn |  | 186 | GND |  | GND
187 | VI_CIF_D11/SDMMC1_CMD_M1/ETH0_TXD3_M1/SAI0_SDI2_M0/PDM0_SDI1_M3/UART1_CTSN_M1/SPI4_CSN0_M3/PCIE0_CLKREQN_M0/GPIO2_B2_d | 3V3 | PCIE0_CLKREQn_M0 |  | 188 | SAI1_MCLK_M0/SAI4_MCLK_M0/AUPLL_CLK_IN_M2/PWM2_CH5_M0/GPIO4_A2_d | 3V3 | SAI1_MCLK_M0
189 | ETH1_RXCTL_M0/UART6_RX_M1/I3C1_SDA_M0/PWM2_CH3_M2/GPIO2_D3_d | 3V3 | GMAC1_RXCTL_M0 |  | 190 | SAI1_LRCK_M0/FLEXBUS1_D12_M1/SPI4_CSN1_M2/UART5_CTSN_M1/I2C2_SDA_M2/PCIE1_CLKREQN_M2/GPIO4_A5_d | 3V3 | SAI1_LRCK_M0
191 | ETH1_RXD0_M0/SAI4_SDO_M3/UART4_RX_M0/I2C6_SDA_M2/PWM2_CH1_M2/GPIO2_D1_d | 3V3 | GMAC1_RXD0_M0 |  | 192 | SAI1_SCLK_M0/FLEXBUS1_CSN_M4/SPI3_CSN0_M2/UART5_RTSN_M1/I2C2_SCL_M2/PWM2_CH4_M1/GPIO4_A3_d | 3V3 | SAI1_SCLK_M0
193 | CAM_CLK0_OUT_M1/ETH1_RXD1_M0/SAI4_MCLK_M3/UART6_TX_M1/I3C1_SCL_M0/PWM2_CH2_M2/GPIO2_D2_d | 3V3 | GMAC1_RXD1_M0 |  | 194 | SAI4_LRCK_M0/PDM1_CLK0_M1/FLEXBUS0_D14_M1/SPI3_MISO_M2/UART6_RX_M0/I2C4_SDA_M1/CAN0_RX_M2/GPIO4_A6_d | 3V3 | CAN0_RX_M2
195 | VI_CIF_D5/ETH1_RXD2_M0/ETH0_PTP_REFCLK_M1/PDM1_SDI1_M0/UART9_RX_M0/PWM1_CH0_M2/GPIO2_C0_d | 3V3 | GMAC1_RXD2_M0 |  | 196 | SAI4_SCLK_M0/PDM1_SDI3_M1/FLEXBUS0_D13_M1/SPI3_MOSI_M2/UART6_TX_M0/I2C4_SCL_M1/CAN0_TX_M2/GPIO4_A4_d | 3V3 | CAN0_TX_M2
197 | VI_CIF_D4/ETH1_RXD3_M0/ETH0_PPSCLK_M1/SAI2_MCLK_M1/PDM1_CLK1_M0/UART9_TX_M0/SPI1_CSN1_M1/PWM1_CH1_M2/GPIO2_C1_d | 3V3 | GMAC1_RXD3_M0 |  | 198 | SAI1_SDO0_M0/SAI4_SDI_M0/SPI3_CLK_M2/PWM2_CH6_M0/GPIO4_A7_d | 3V3 | PWM2_CH6_M0_CAM SAI1_SDO0_M0
199 | ETH1_TXCTL_M0/SAI4_SDI_M3/UART4_TX_M0/I2C6_SCL_M2/PWM2_CH0_M2/GPIO2_D0_d | 3V3 | GMAC1_TXCTL_M0 |  | 200 | SAI1_SDO1_M0/SAI1_SDI3_M0/PDM1_CLK1_M1/FLEXBUS1_D13_M1/SPI4_CLK_M2/UART5_TX_M1/UART6_RTSN_M0/UART2_RTSN_M1/GPIO4_B0_d | 3V3 | GPIO_40
201 | ETH1_TXD0_M0/SAI4_SCLK_M3/UART4_CTSN_M0/I2C5_SCL_M2/PWM1_CH5_M2/GPIO2_C6_d | 3V3 | GMAC1_TXD0_M0 |  | 202 | SAI1_SDO2_M0/SAI1_SDI2_M0/PDM1_SDI2_M1/FLEXBUS1_D14_M1/SPI4_MOSI_M2/UART5_RX_M1/UART6_CTSN_M0/UART2_CTSN_M1/GPIO4_B1_d | 3V3 | GPIO_38
203 | ETH1_TXD1_M0/SAI4_LRCK_M3/UART4_RTSN_M0/I2C5_SDA_M2/PWM0_CH1_M2/GPIO2_C7_d | 3V3 | GMAC1_TXD1_M0 |  | 204 | SAI1_SDO3_M0/SAI1_SDI1_M0/PDM1_SDI1_M1/FLEXBUS1_D15_M1/SPI4_MISO_M2/MIPI_TE_M0/GPIO4_B2_d | 3V3 | GPIO_35
205 | VI_CIF_D2/ETH1_TXD2_M0/SAI2_LRCK_M1/PDM1_SDI3_M0/UART11_RTSN_M1/SPI1_MISO_M1/PWM0_CH0_M2/GPIO2_C3_d | 3V3 | GMAC1_TXD2_M0 |  | 206 | SAI1_SDI0_M0/SAI4_SDO_M0/PDM1_SDI0_M1/SPI4_CSN0_M2/SPI3_CSN1_M2/PWM2_CH7_M0/GPIO4_B3_d | 3V3 | SAI1_SDI0_M0
207 | VI_CIF_D1/ETH1_TXD3_M0/SAI2_SDO_M1/PDM1_SDI0_M0/UART11_TX_M1/SPI1_CSN0_M1/PWM1_CH3_M2/GPIO2_C4_d | 3V3 | GMAC1_TXD3_M0 |  | 208 | SPDIF_RX0_M0/FLEXBUS0_CSN_M4/UART2_RX_M1/I2C3_SDA_M0/CAN1_RX_M2/GPIO4_B4_d | 3V3 | GPIO_10
209 | VO_LCDC_D19/VO_EBC_SDCE3/ETH0_MCLK_M0/SAI4_MCLK_M1/DSMC_CSN1/FLEXBUS0_D8/UART10_RX_M0/SPI2_MOSI_M2/PWM0_CH0_M3/GPIO3_B0_d | 1V8 | DSI_IO0 |  | 210 | SPDIF_TX0_M0/FLEXBUS0_D15_M1/UART2_TX_M1/I2C3_SCL_M0/PCIE0_CLKREQN_M2/CAN1_TX_M2/GPIO4_B5_d | 3V3 | GPIO_8
211 | GND |  | GND |  | 212 | GND |  | GND
213 | PHY0_LED1/CFG_LDO0 | - | PHY0_LED1/CFG_LDO0 | GMAC0 | 214 | SARADC_IN0_BOOT | 1V8 | SARADC_VIN0_BOOT
215 | PHY0_LED2/CFG_LDO1 | - | PHY0_LED2/CFG_LDO1 |  | 216 | SARADC_IN1 | 1V8 | SARADC_VIN1_KEY/RECOVERY
217 | PHY0_MDI0+ | - | PHY0_MDI0+ |  | 218 | SARADC_IN3 | 1V8 | SARADC_VIN3_HP_HOOK
219 | PHY0_MDI0- | - | PHY0_MDI0- |  | 220 | SARADC_IN4 | 1V8 | SARADC_VIN4
221 | PHY0_MDI1+ | - | PHY0_MDI1+ |  | 222 | SARADC_IN5 | 1V8 | SARADC_VIN5
223 | PHY0_MDI1- | - | PHY0_MDI1- |  | 224 | SARADC_IN6 | 1V8 | SARADC_VIN6
225 | PHY0_MDI2+ | - | PHY0_MDI2+ |  | 226 | SARADC_IN7 | 1V8 | SARADC_VIN7
227 | PHY0_MDI2- | - | PHY0_MDI2- |  | 228 | GND |  | GND
229 | PHY0_MDI3+ | - | PHY0_MDI3+ |  | 230 | PMIC_EXT_EN_OUT |  | NC
231 | PHY0_MDI3- | - | PHY0_MDI3- |  | 232 | PWRON_L |  | PWRON_L
233 | GND |  | GND |  | 234 | 32KOUT_RTC2WIFI | 3V3 | 32KOUT_RTC2WIFI
235 | VCC_3V3_S0 |  | VCC_3V3_S0 |  | 236 | VCC_1V8_S0 |  | VCC_1V8_S0
237 | VCC_3V3_S0 |  | VCC_3V3_S0 |  | 238 | VCC_1V8_S0 |  | VCC_1V8_S0
239 | VCC_3V3_S3 |  | VCC_3V3_S3 |  | 240 | VCC_1V8_S3 |  | VCC_1V8_S3
241 | VCC_3V3_S3 |  | VCC_3V3_S3 |  | 242 | VCC_1V8_S3 |  | VCC_1V8_S3
243 | GND |  | GND |  | 244 | GND |  | GND
245 | GND |  | GND |  | 246 | GND |  | GND
247 | GND |  | GND |  | 248 | GND |  | GND
249 | GND |  | GND |  | 250 | GND |  | GND
251 | VCC5V_DCIN |  | VCC5V_DCIN |  | 252 | VCC5V_DCIN |  | VCC5V_DCIN
253 | VCC5V_DCIN |  | VCC5V_DCIN |  | 254 | VCC5V_DCIN |  | VCC5V_DCIN
255 | VCC5V_DCIN |  | VCC5V_DCIN |  | 256 | VCC5V_DCIN |  | VCC5V_DCIN
257 | VCC5V_DCIN |  | VCC5V_DCIN |  | 258 | VCC5V_DCIN |  | VCC5V_DCIN
259 | VCC5V_DCIN |  | VCC5V_DCIN |  | 260 | VCC5V_DCIN |  | VCC5V_DCIN
