LuckfoxTECH/Luckfox-Omni3576-docs/Hardware/3D Models/Core3576.step

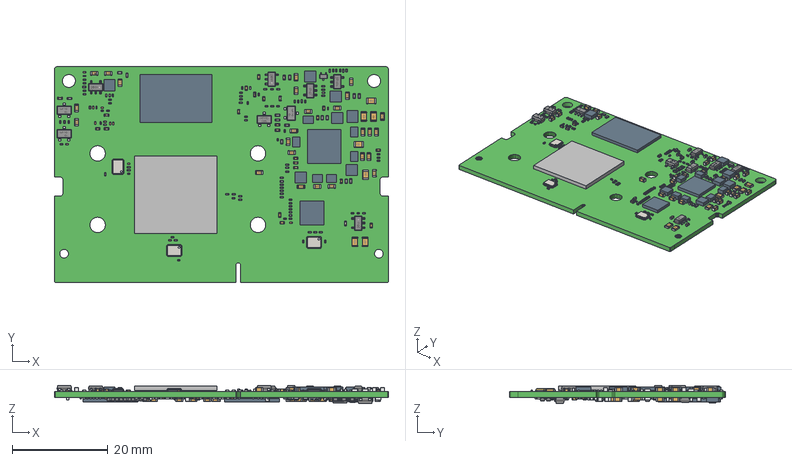
[picture p1: CAD file, 2026-07-14]
Hardware/3D Models/Core3576.step
69.6 x 45.0 x 3.80 mm
Board
User_Library-RES_0603-0201 x 164
User_Library-0201(0603M)_Cap x 185
Extruded x 20
User_Library-3225-1 x 3
SOT23-5AND6_00 x 30
SOT23-5-14065_AF0 x 6
5_1_2_A x 25
_7_AF0 x 25
SOT-23 x 5
User_Library-SOT-523 x 9
3_1_A x 60
3_1_2_A x 70
4_A x 10
SOD323
