LuckfoxTECH/Luckfox-Omni3576-docs/(list of files, cad)

Other CAD files:
Hardware/3D Models/Omni3576.step
Hardware/CAD/Core3576.DWG
Hardware/CAD/Omni3576.DWG
