LuckfoxTECH/Luckfox-Omni3576-docs/Hardware/Schematic/Omni3576.pdf

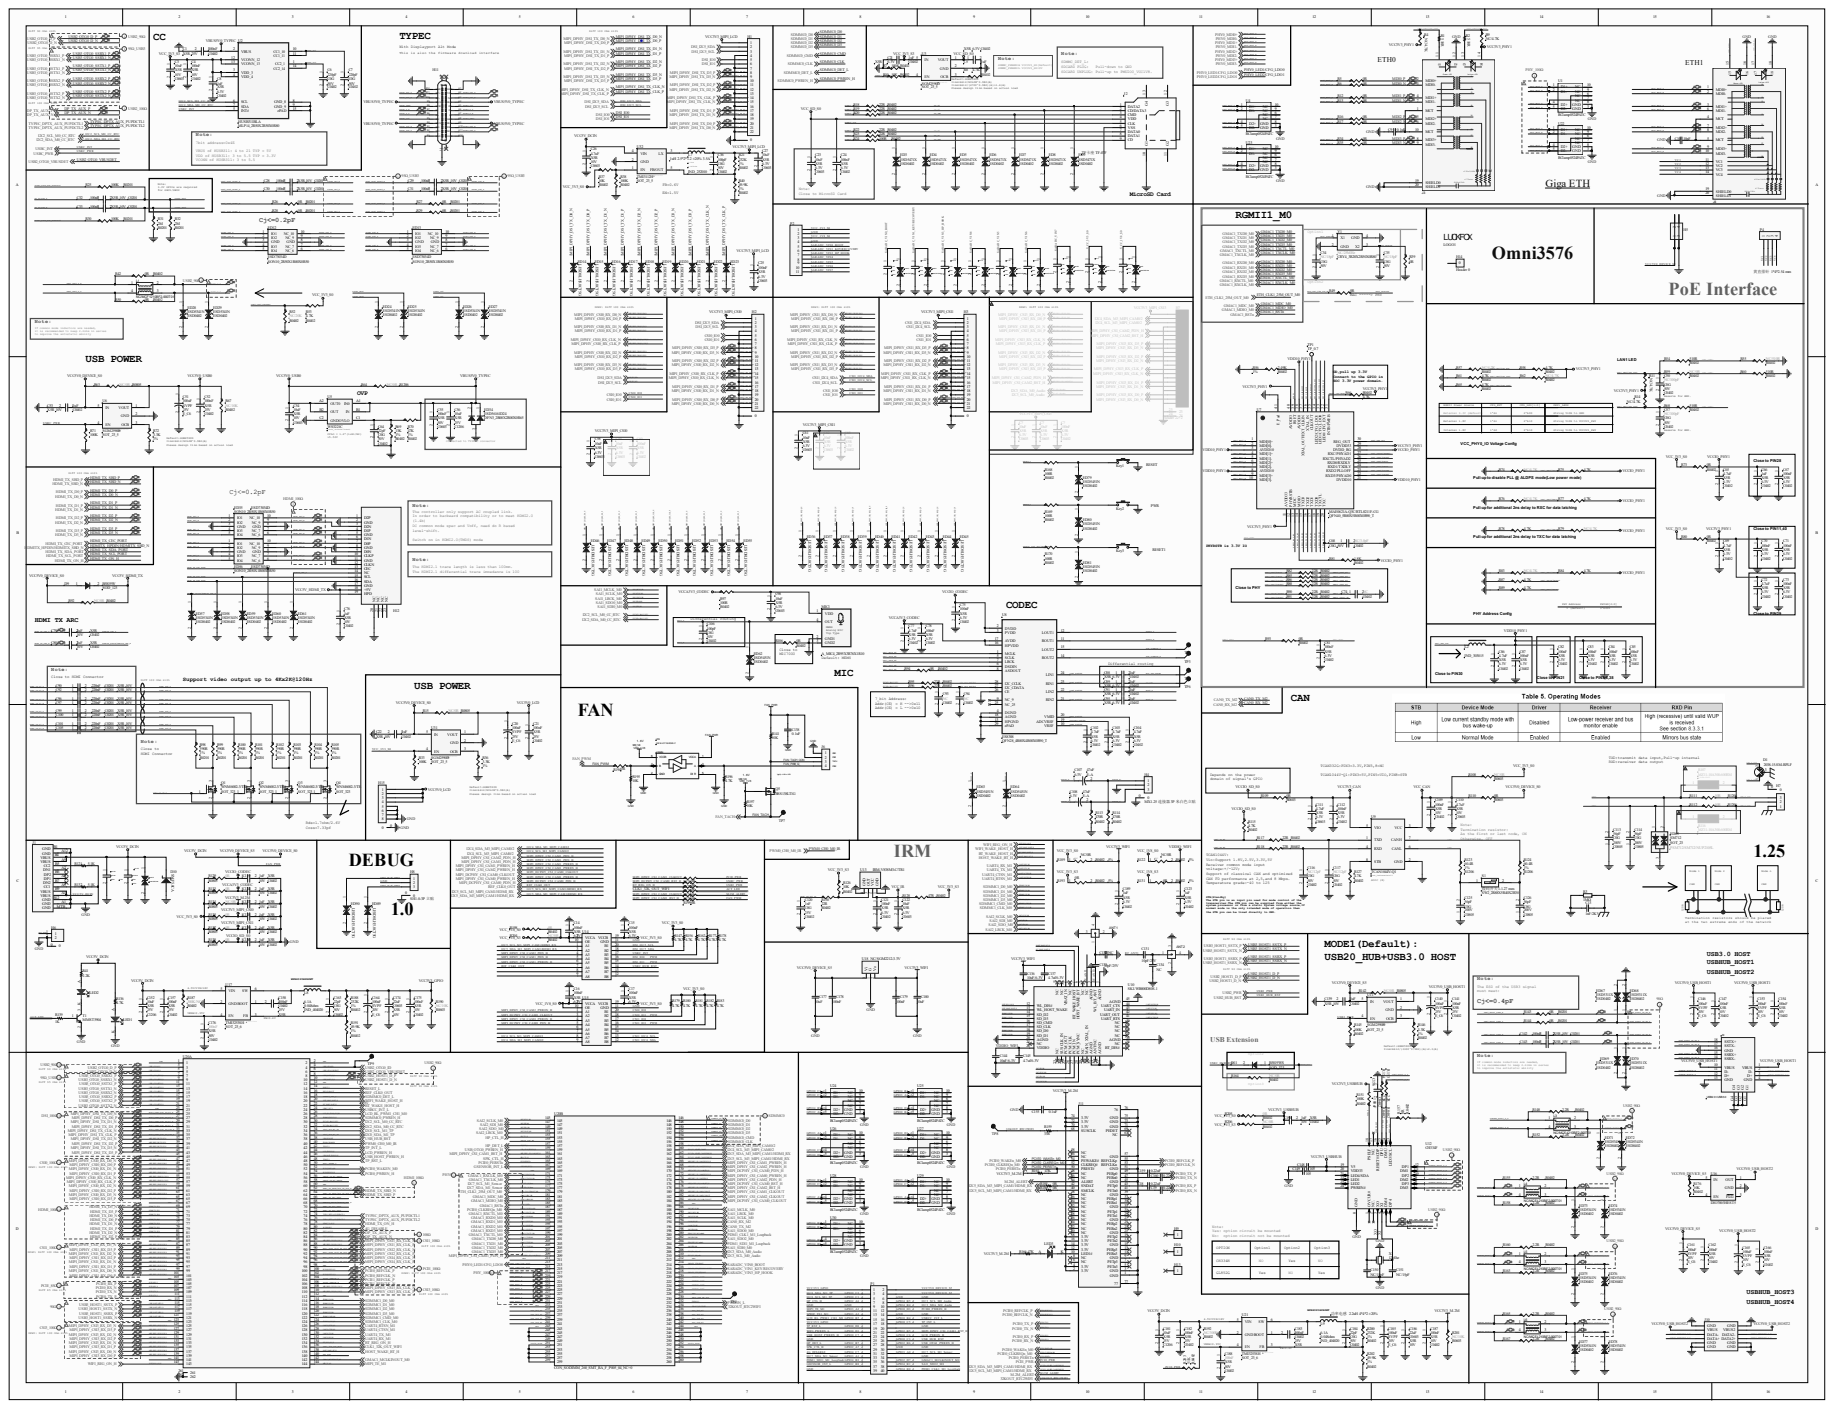
[picture p27: page 1]

This is also the firmware download interface

With Displayport Alt Mode

SDMMC_DET_L:
SDCARD UNPLUG: Pull-up to PMUIO0_VCC1V8.

Default:SGM2590D
Ilim=6612/RILIM^0.982(A)
Ilim=6612/(4700^0.982)(A)≈1.6(A) Please design Ilim based on actual load

VBUS of HUSB311: 4 to 21 TYP = 5V
VDD of HUSB311: 3 to 5.5 TYP = 3.3V
VCONN of HUSB311: 3 to 5.5

MicroSD Card Note:
Close to MicroSD Card

If common mode inductors are needed,
it is recommended to keep 2.2ohm in series
to improve the antistatic ability

OD,pull up 3.3V
Connect to the GPIO in
SOC 3.3V power domain.

INTB/PMEB 31 LED0/CFG_EXT 32 LED1/CFG_LDO0 33 LED2/CFG_LDO1 34 CLKOUT 35 XTAL_IN 36 XTAL_OUT/EXT_CLKIN 37 AVDD10 38 RSET 39 AVDD33 40

Please design Ilim based on actual load

Note:
Connected to TYPE C connector

Pull-up to disable PLL @ ALDPS mode(Low power mode)

The controller only support AC coupled link.
In order to backward compatibility or to meet HDMI2.0
DC common mode spec and Voff, need do R based
level-shift.

Pull-up for additional 2ns delay to RXC for data latching

Switch on in HDMI2.0(TMDS) mode
Switch off in HDMI2.1(FRL) mode.

Pull-up for additional 2ns delay to TXC for data latching

The HDMI2.1 trace length is less than 100mm.
The HDMI2.1 differential trace impedance is 100
OHM.

Close to HDMI Connector

Support video output up to 4Kx2K@120Hz

TXD:transmit data input,Pull-up internal
RXD:receiver data output

Depends on the power
domain of signal's GPIO

Termination resistor:
As the first or last node, ON
Otherwise, OFF

Support of classical CAN and optimized
CAN FD performance at 2,5,and 8 Mbps.
Temperature grade:-40 to 125

STB(Standby)
The STB pin is an input pin used for mode control of the
transcervier.The STB pin can be supplied from either the
system processor or from a static system voltage source,If
normal mode is the only intended mode of operation then
the STB pin can be tired directly to GND.

Termination resistors should be placed
at the two extreme ends of the network

AGND 1 WL_BT_ANT 2 AGND 3 NC 4 NC 5 HOST_WAKE_BT 6 BT_WAKE_HOST 7 NC 8 VBAT_IN 9 NC 10 NC 11

The ESD of the USB3 signal
must meet:

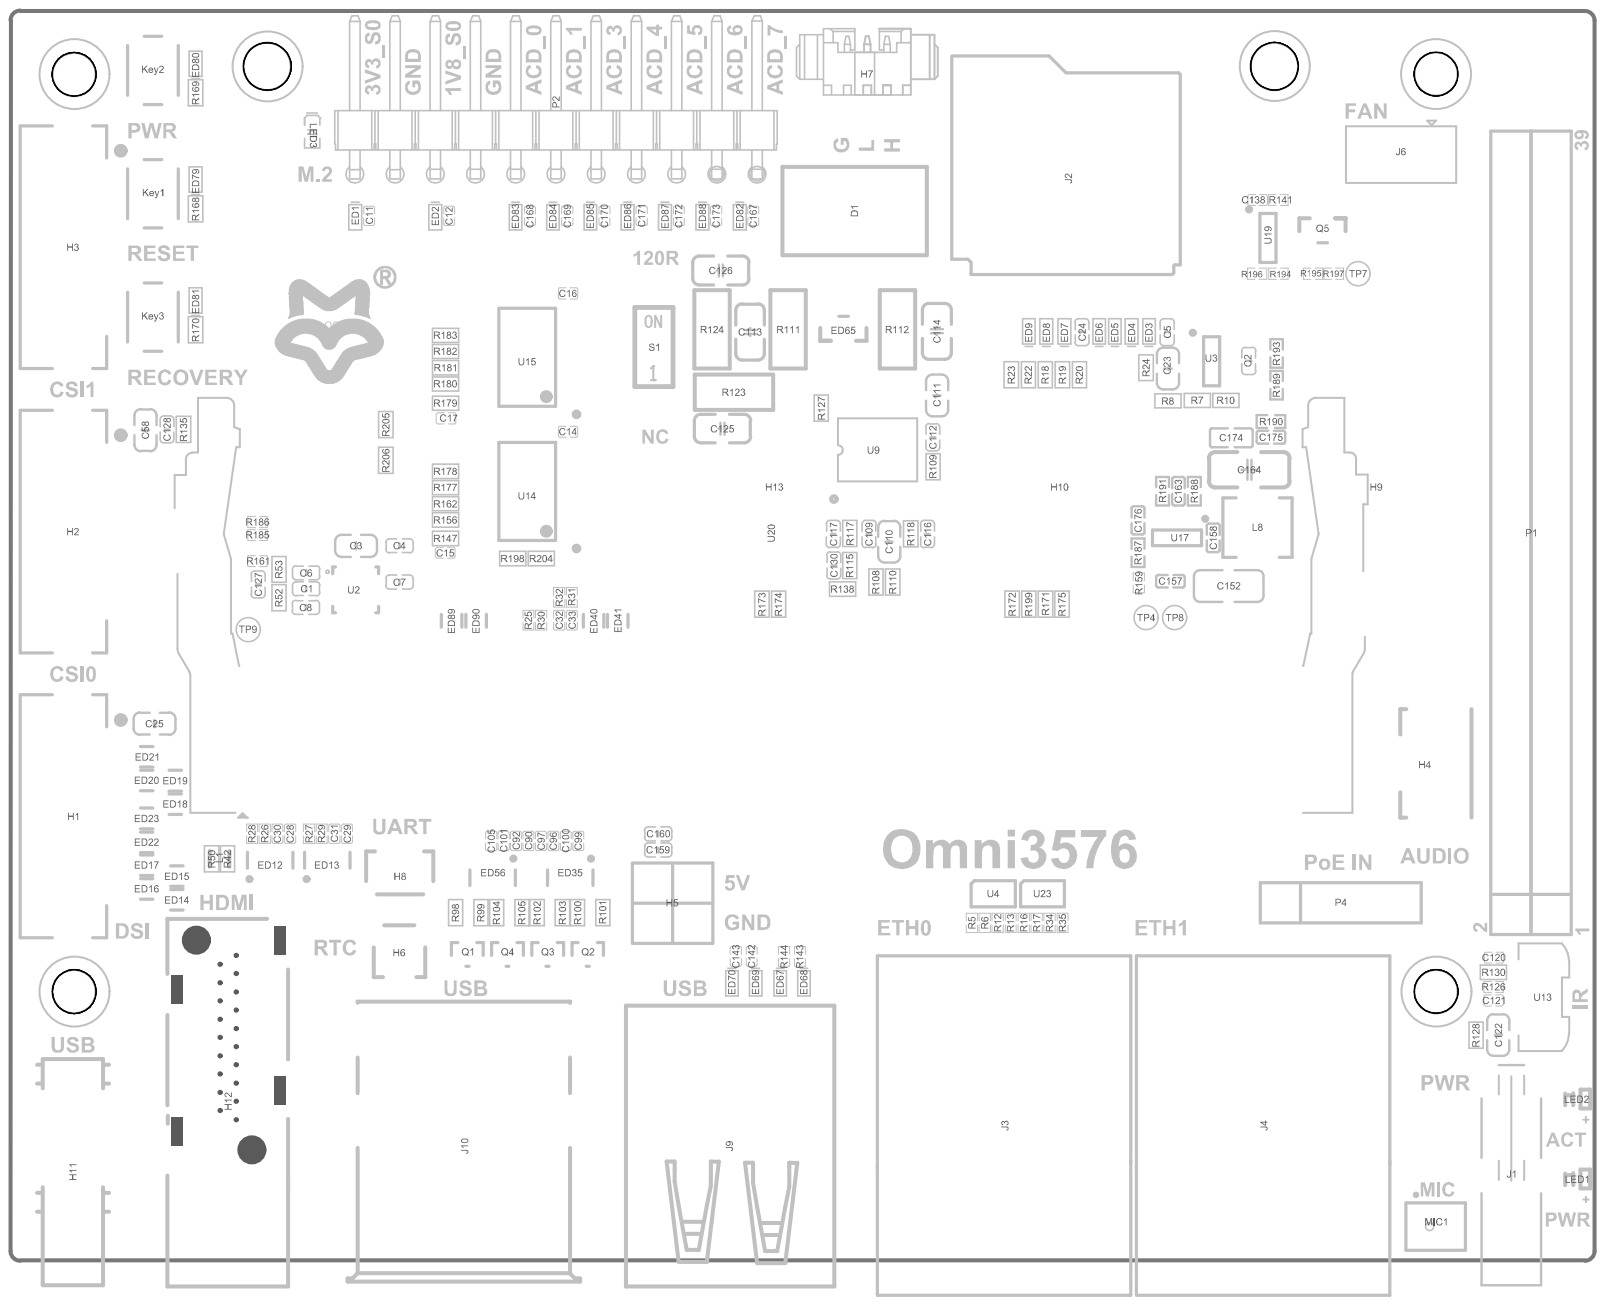
[picture p28: page 2]

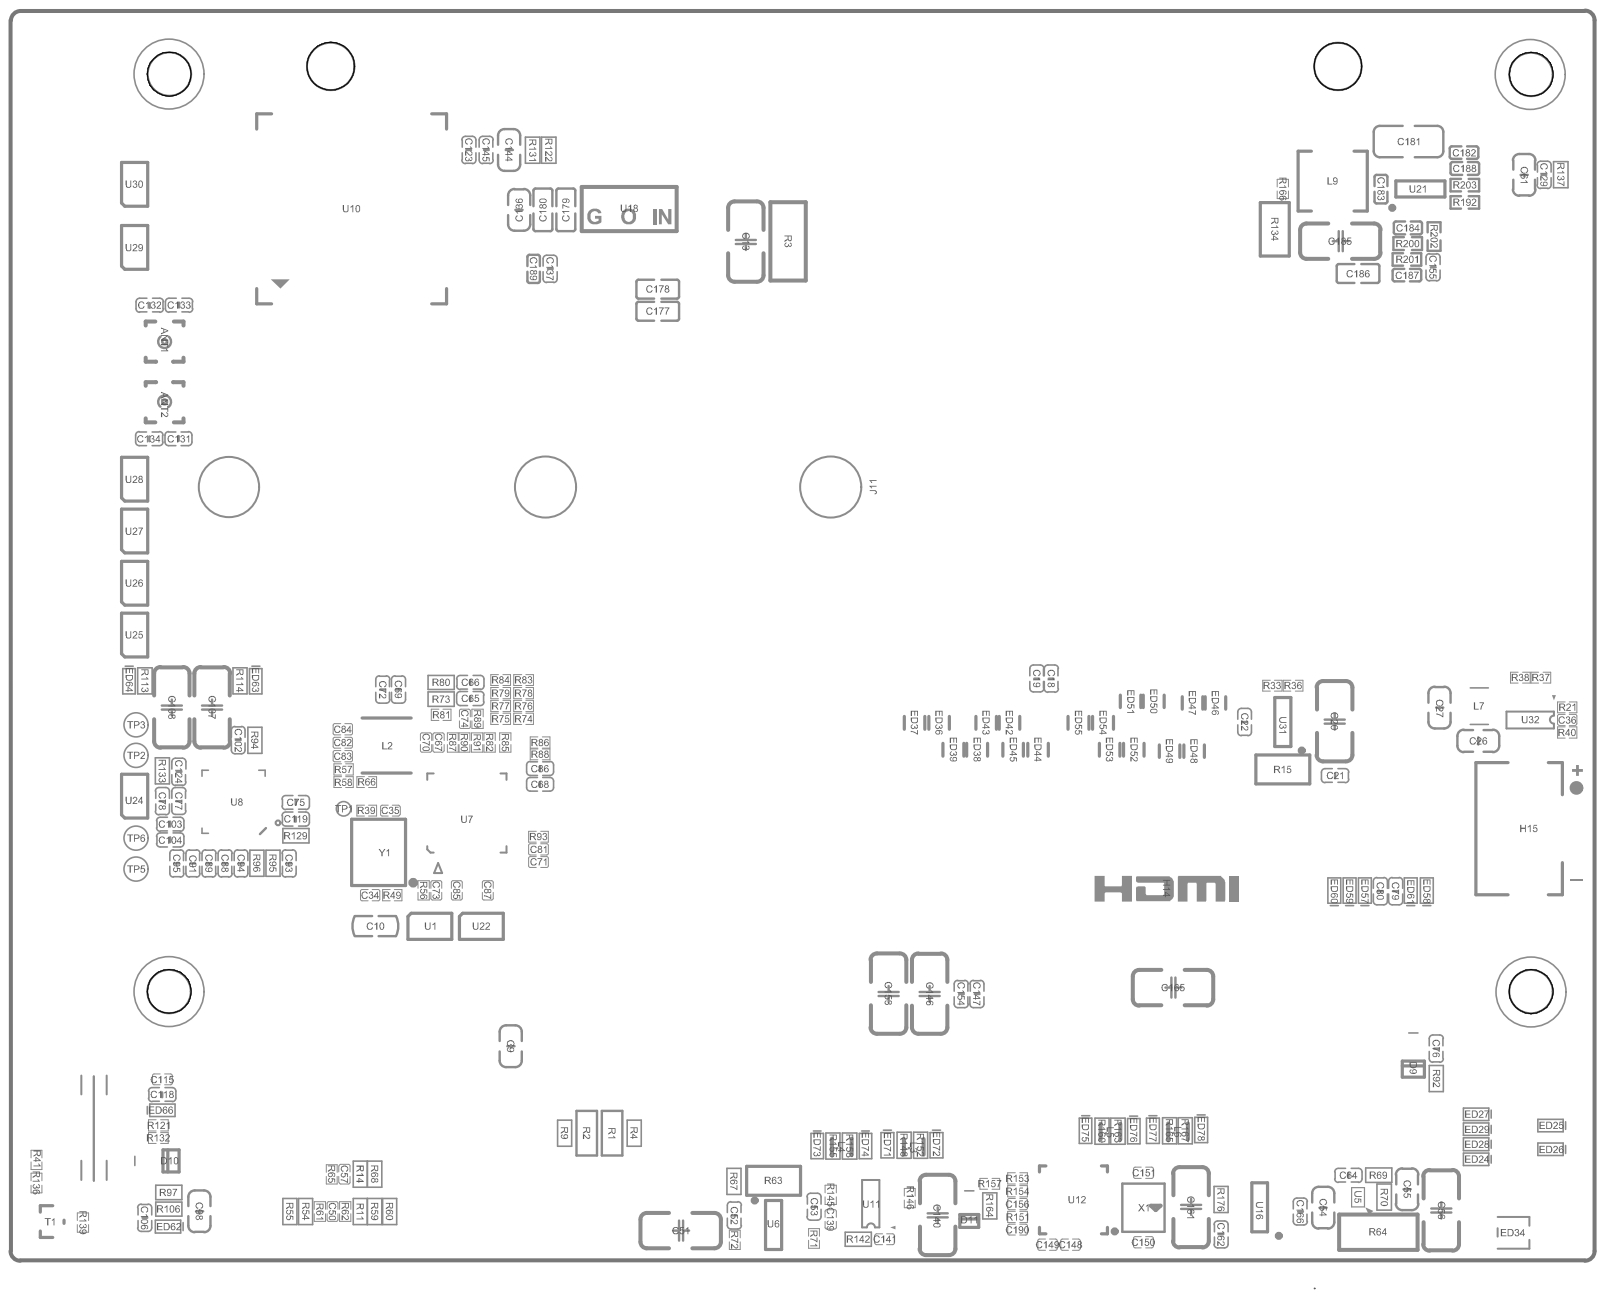
[picture p29: page 3]
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
